TheJonBovi/AutomatedSmartBlinds/ASBWeb/ASBWeb/assets/img/testmonial/1.png

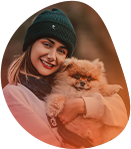
ASBWeb/ASBWeb/assets/img/testmonial/1.png
