TheJonBovi/AutomatedSmartBlinds/ASBWeb/ASBWeb/assets/img/elements/d.jpg

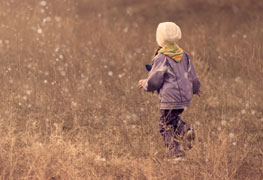
ASBWeb/ASBWeb/assets/img/elements/d.jpg
