TheJonBovi/AutomatedSmartBlinds/Semester1_turn_in/ASB_Presentation_Slides.pdf

# Automated Smart Blinds

### By: Andrew Deraita, Chad Revel, Michael Roberts

# What Are Automated Smart Blinds?

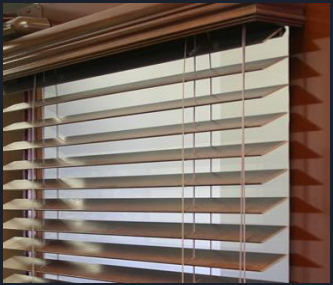
[picture p52: figure]

### - Fully Automated Blinds

### - Controlled By Web Interface

### - Numerous Custom Settings

### - Settings Can Be Changed Web

### Interface

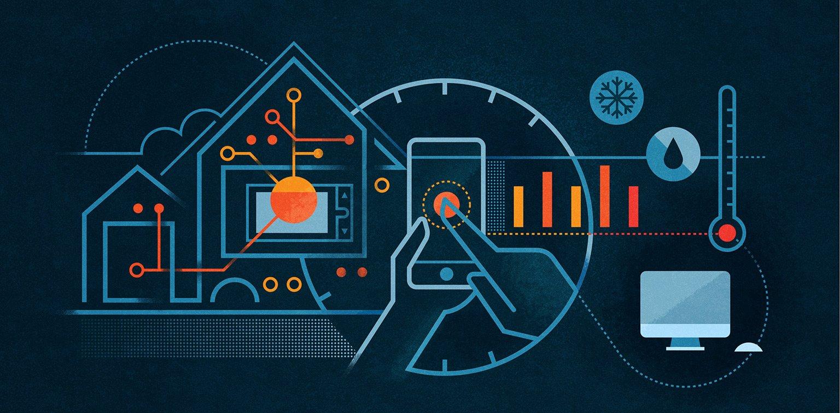
[picture p53: figure]

# Why is this important?

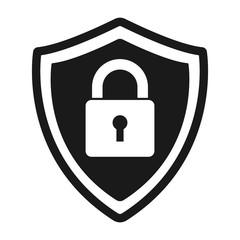
[picture p54: figure]

### - Next Step In Smart Houses

### - Help For Disabled Individuals

### - Security

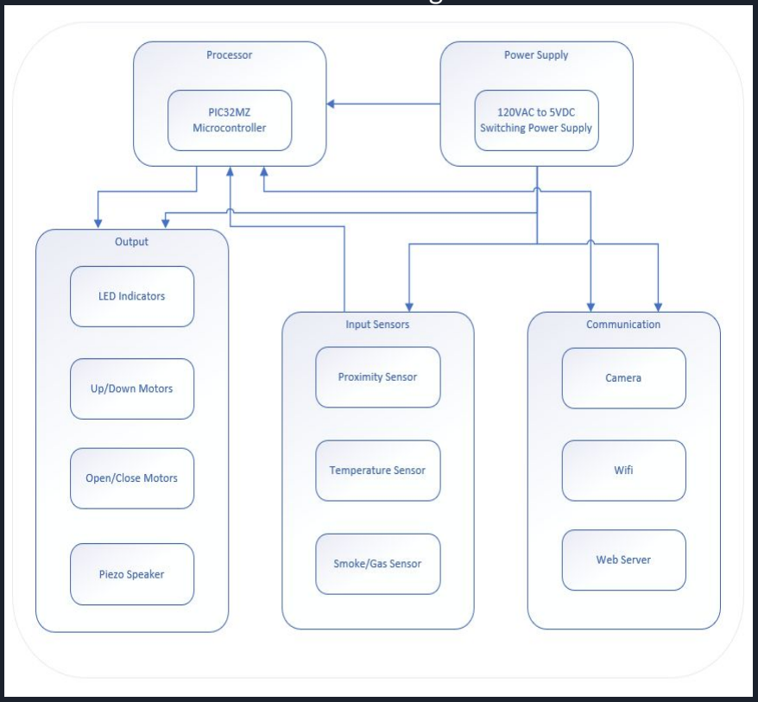
[picture p55: figure]

# How it works

### - Multiple Sensors

- Temperature
- Proximity
- Smoke/Gas

### - Settings like time of day/night

### - User input via web interface

### Overall diagram

# Processor

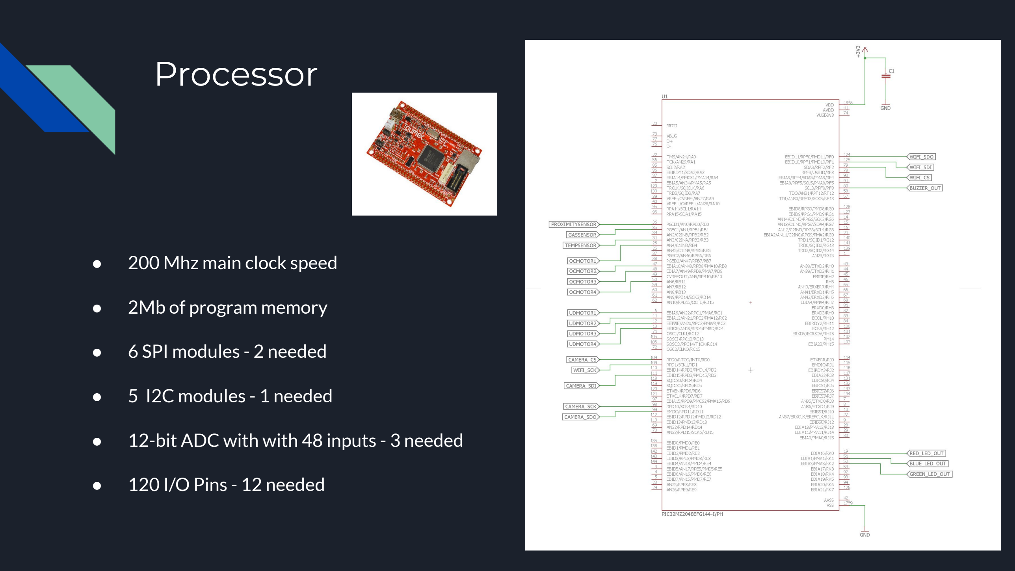
[picture p56: page 5]

### - 200 Mhz main clock speed

### - 2Mb of program memory

### - 6 SPI modules - 2 needed

### - 5 I2C modules - 1 needed

### - 12-bit ADC with with 48 inputs - 3 needed

### - 120 I/O Pins - 12 needed

# Processor RTS Loop

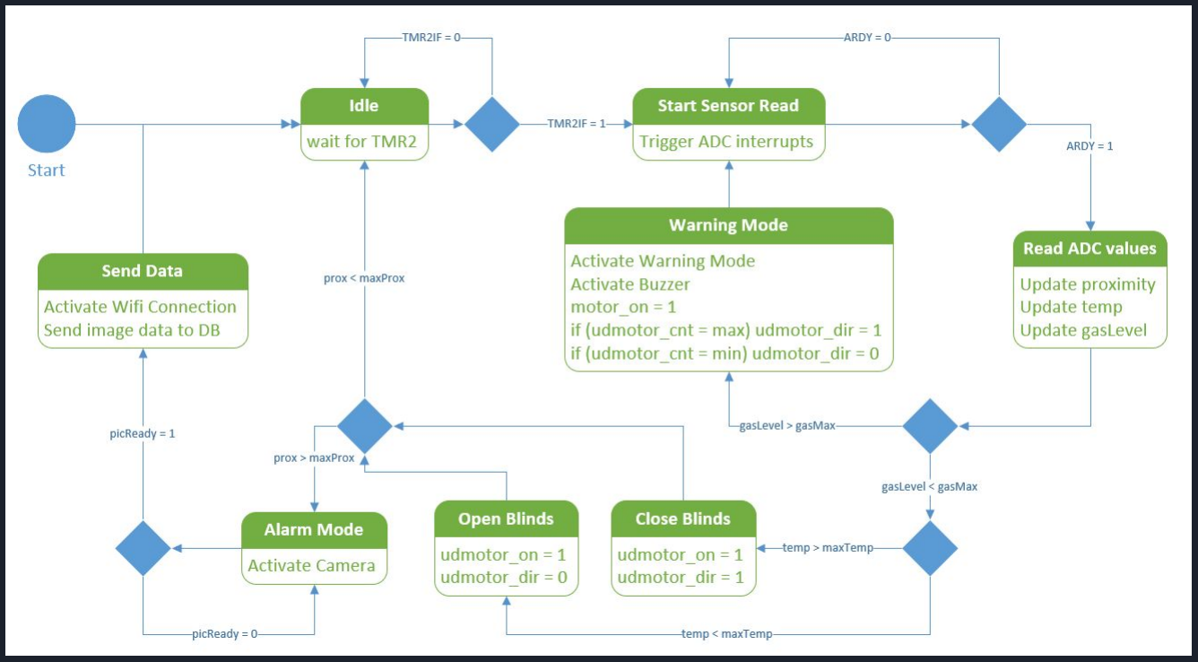
[picture p57: figure]

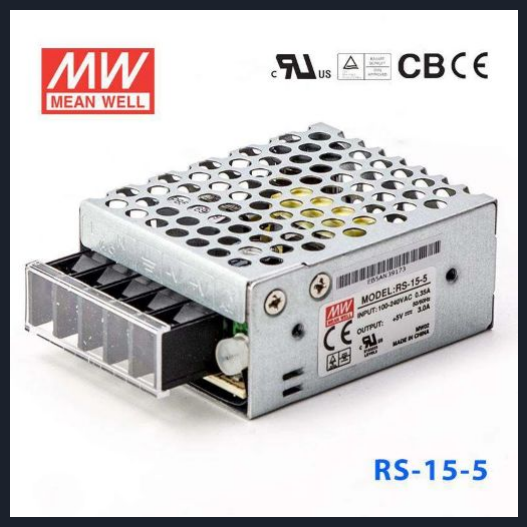
[picture p58: figure]

# Power Supply

### - RS-15-5 5V, 3A Switching Power Supply

### - LM340H 3.3V Linear Power Regulator

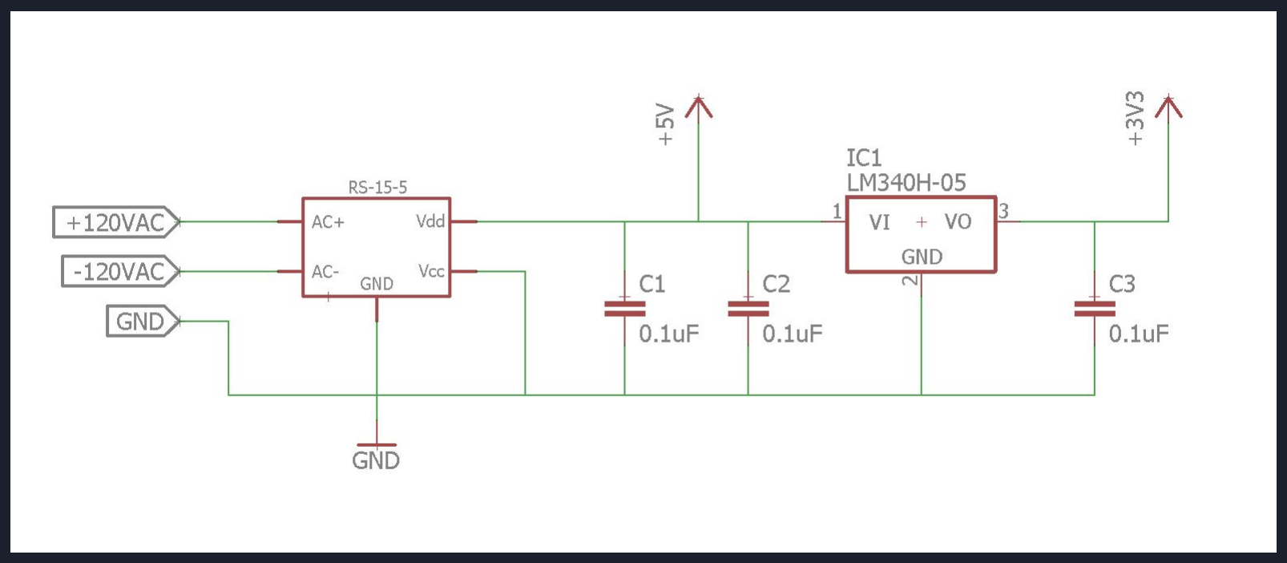
[picture p59: figure]

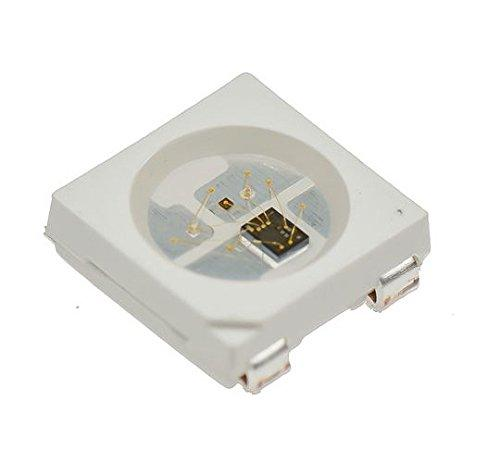
[picture p60: figure]

# LED Indicators

### - High Power 5050RGB LED

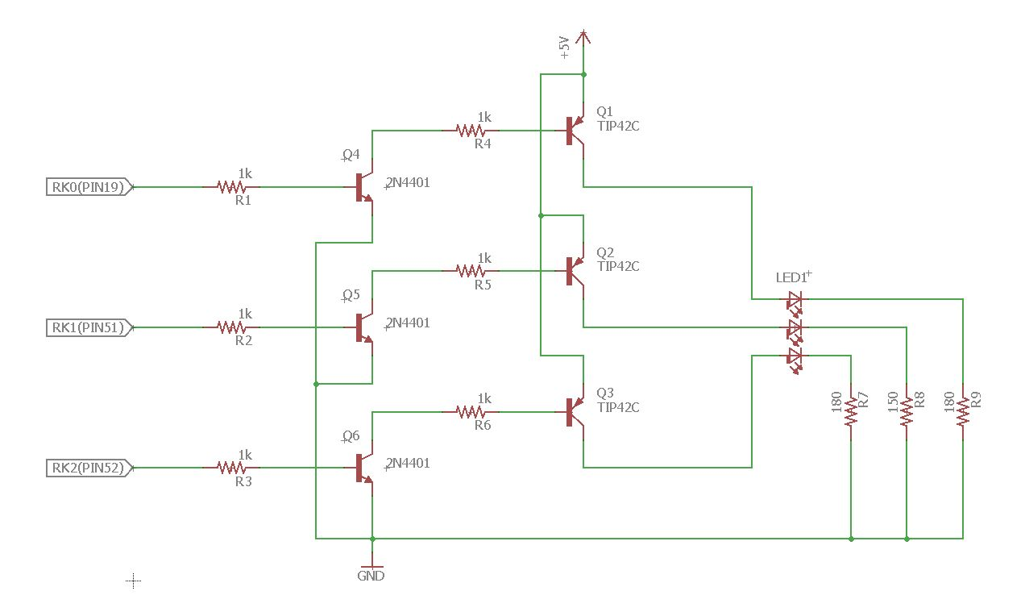
[picture p61: figure]

### - 2-stage power amplification

- Voltage amplification
- Current amplification

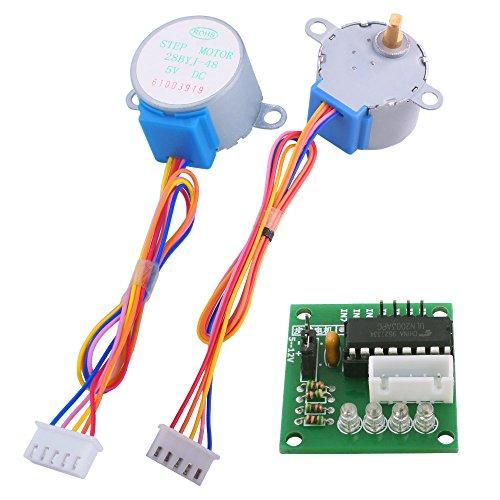
[picture p62: figure]

# Stepper Motor (up/down and open/close)

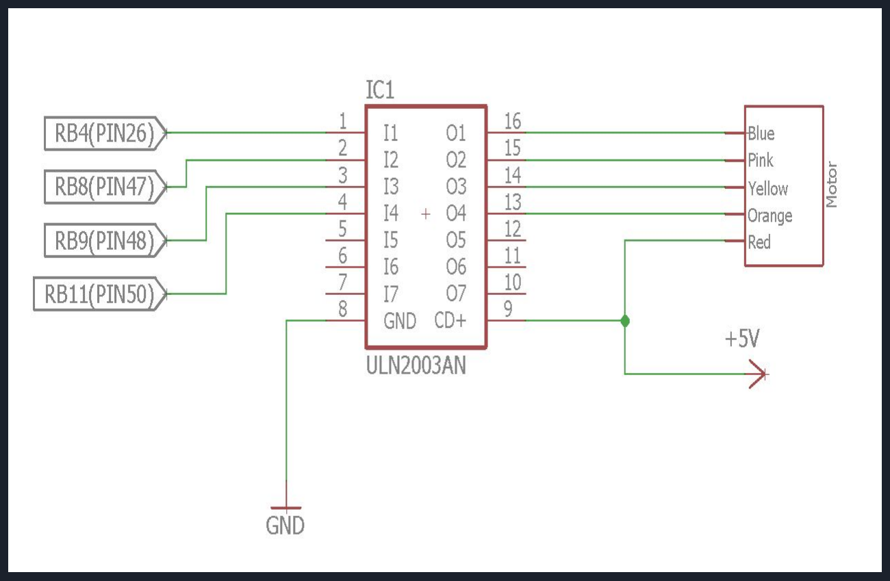
[picture p63: figure]

### - 5V DC

### - 4-Phase

### - 5-Wire

### - ULN2003 Driver Board

### - Pull in Torque 34.4mN.m (120Hz)

### - 8 signals repeated 64 times for one full

### revolution

# Stepper Motor State Machine

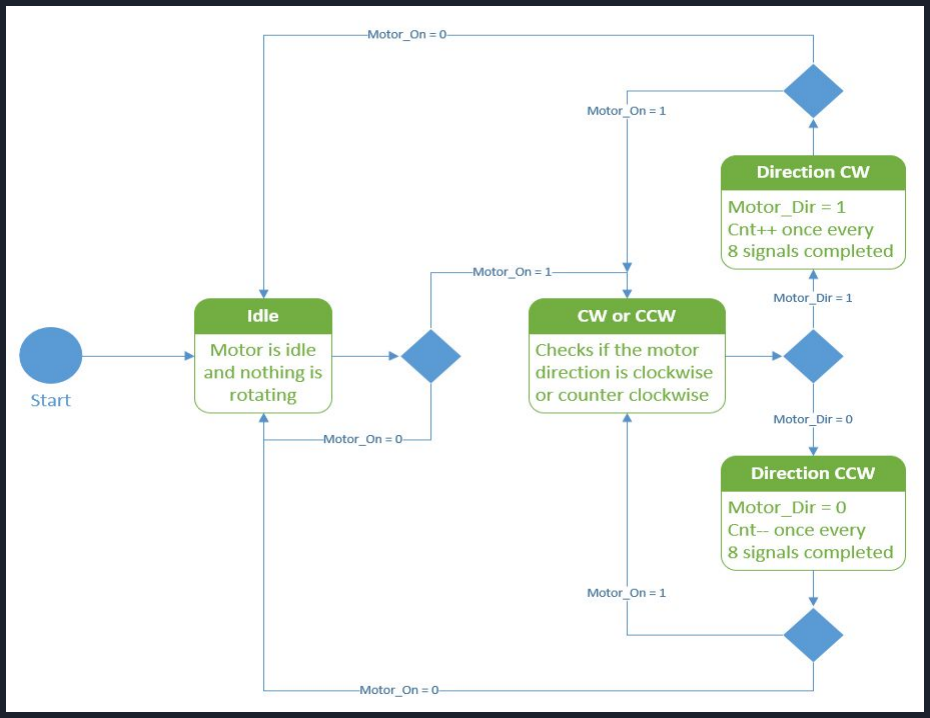
[picture p64: figure]

# Stepper Motor State Machine

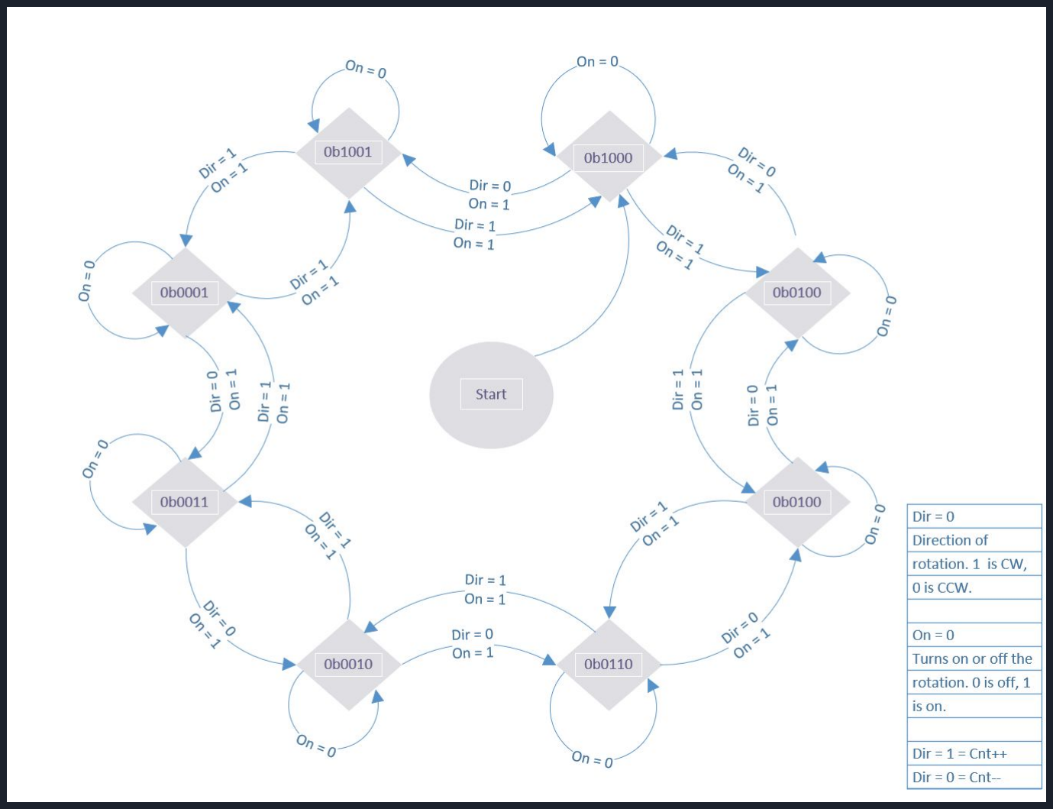
[picture p65: figure]

# Blinds

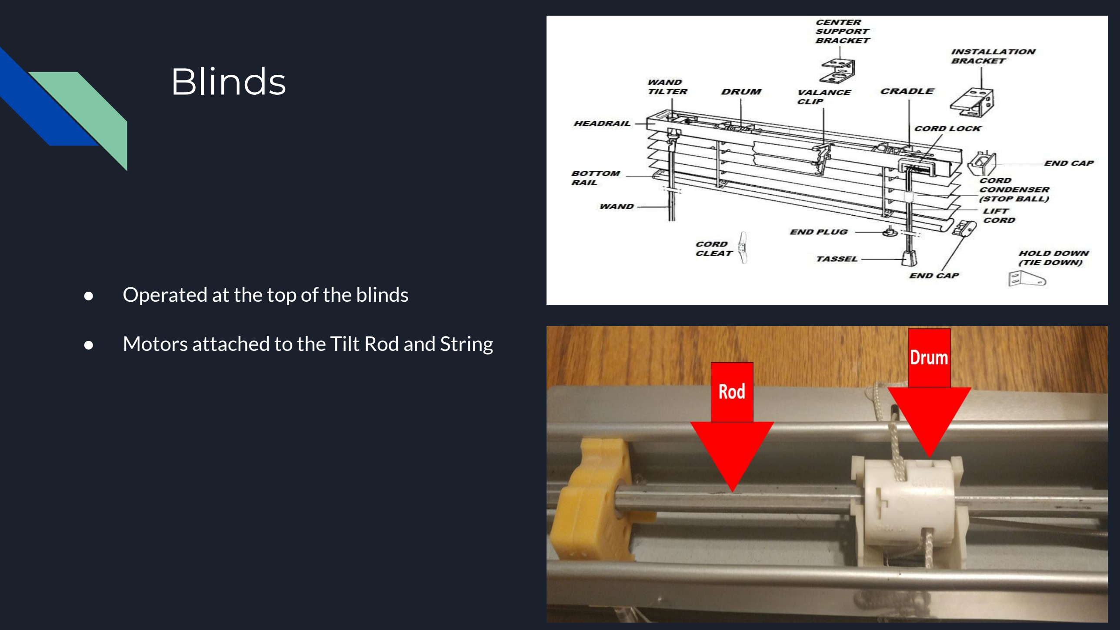
[picture p66: page 12]

### - Operated at the top of the blinds

### - Motors attached to the Tilt Rod and String

# Speaker

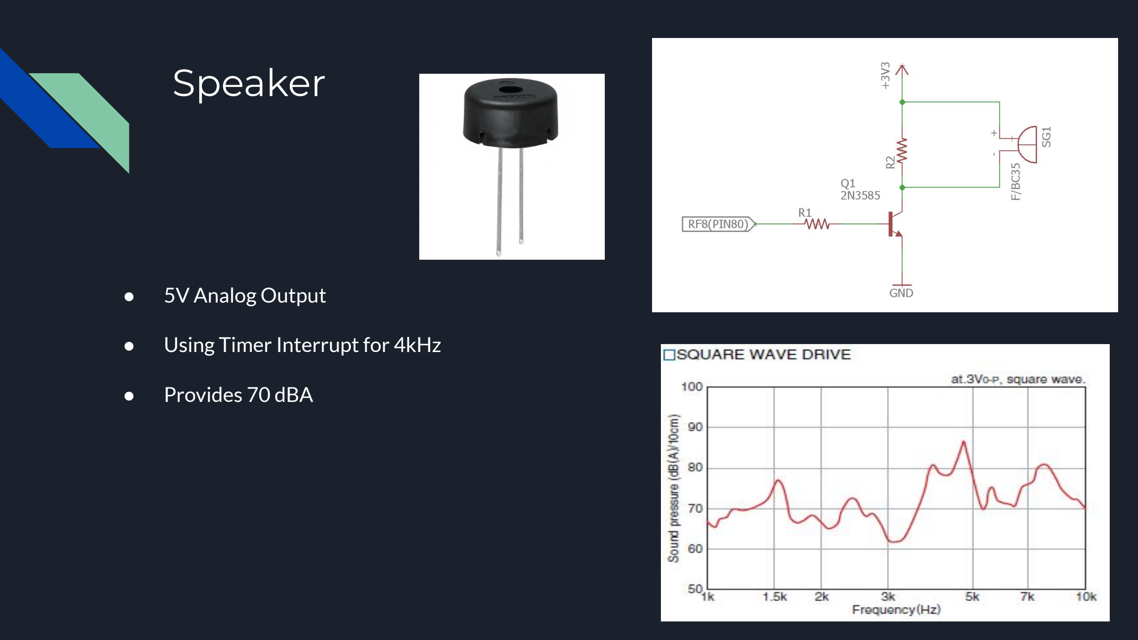
[picture p67: page 13]

### - 5V Analog Output

### - Using Timer Interrupt for 4kHz

### - Provides 70 dBA

# Proximity Sensor

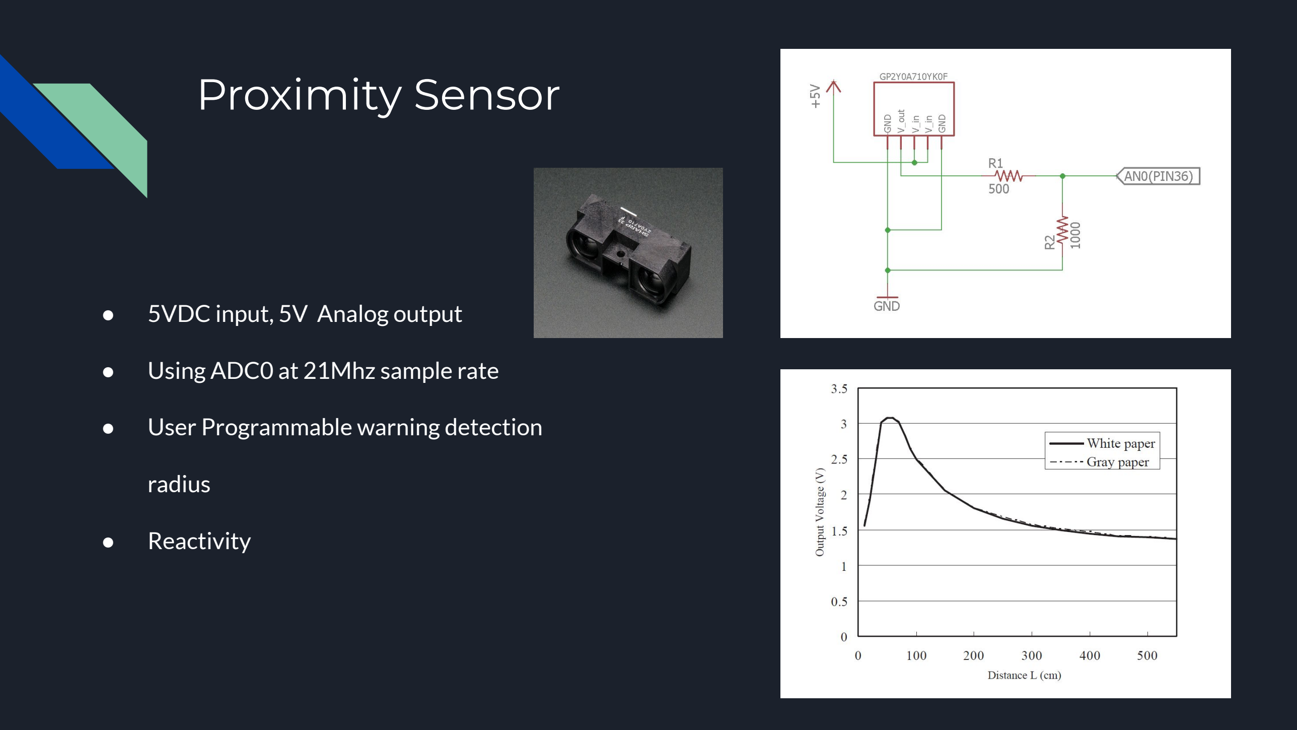
[picture p68: page 14]

### - 5VDC input, 5V Analog output

### - Using ADC0 at 21Mhz sample rate

### - User Programmable warning detection

### radius

### - Reactivity

# Temperature Sensor

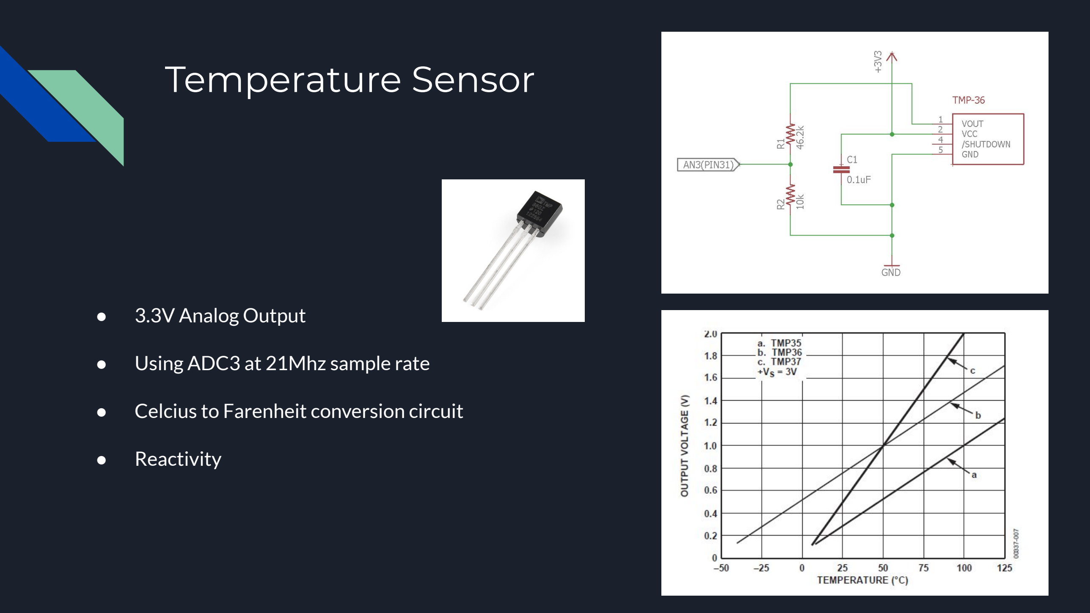
[picture p69: page 15]

### - 3.3V Analog Output

### - Using ADC3 at 21Mhz sample rate

### - Celcius to Farenheit conversion circuit

### - Reactivity

# Smoke/Gas Sensor

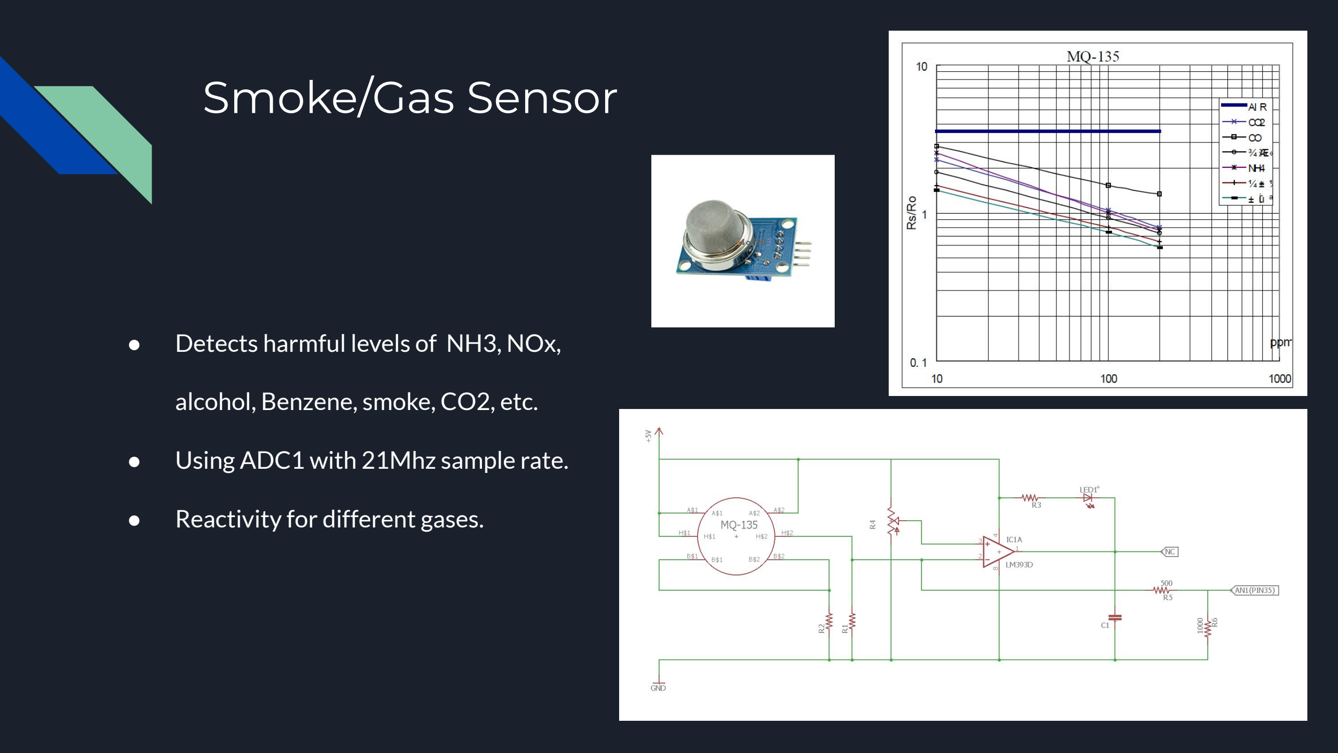
[picture p70: page 16]

- Detects harmful levels of NH3, NOx,

alcohol, Benzene, smoke, CO2, etc.

- Using ADC1 with 21Mhz sample rate.
- Reactivity for different gases.

# Camera

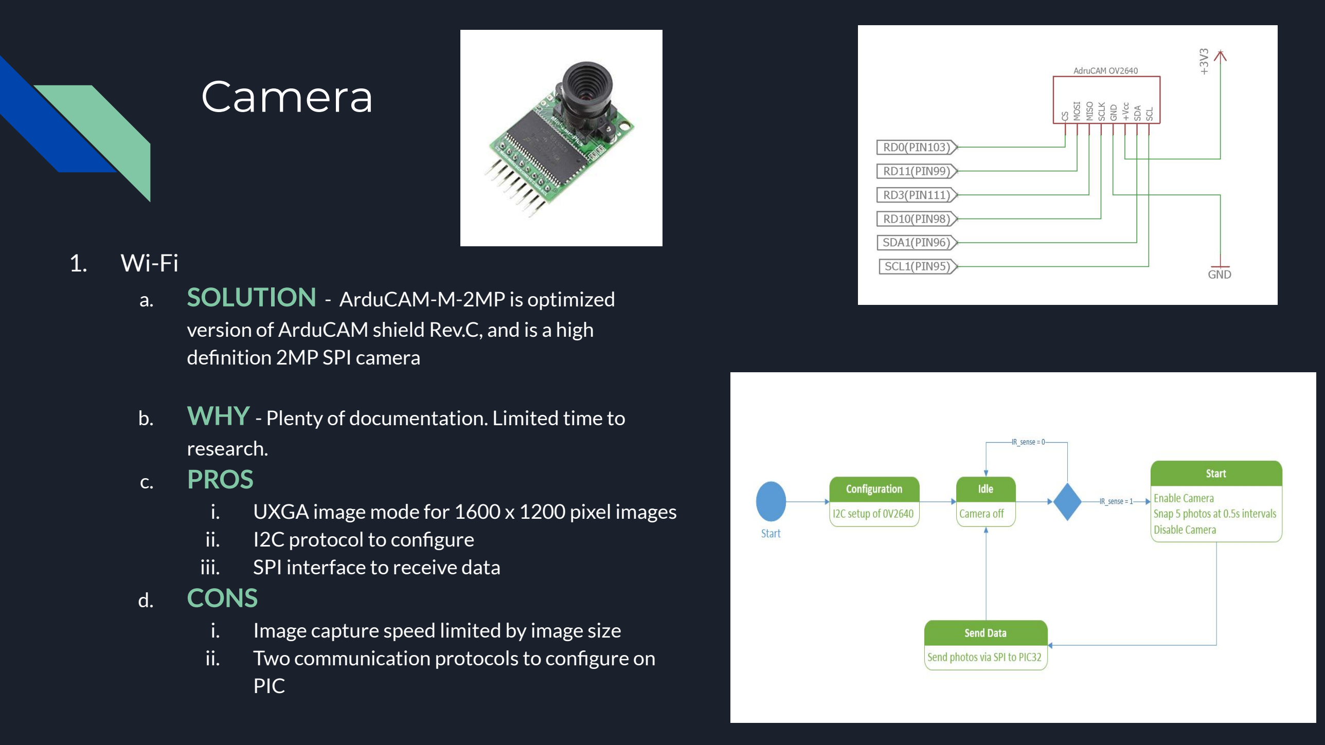
[picture p71: page 17]

### 1. Wi-Fi

a. SOLUTION - ArduCAM-M-2MP is optimized version of ArduCAM shield Rev.C, and is a high definition 2MP SPI camera
b. WHY - Plenty of documentation. Limited time to research.

### c. PROS

i. UXGA image mode for 1600 x 1200 pixel images
ii. | I2C protocol to configure
iii. | SPI interface to receive data

### d. CONS

i. Image capture speed limited by image size
ii. | Two communication protocols to configure on
| PIC

# Communications (Hardware)

### 1. Wi-Fi

a. SOLUTION - IEEE 802.11, (b/g/n) standard specifications. TCP/IP Stack
b. WHY - Current Trend in IoT is to used WiFi. Stretch goal to incorporate video streaming. Also, couldn’t find a bluetooth module to support video application in enough time before initial parts had to be ordered. We knew all End-User devices could connect to a local network.

### c. PROS

i. Scalability
ii. Connectivity - can be connected to remotely via internet

### d. CONS

i. Cost vs RFID, Bluetooth
ii. Power vs RFID, Bluetooth
e. TEST - Arduino, SAMD21

# Communications (Software)

### 1. User Interface

a. SOLUTION - WISA(Microsoft Windows, Microsoft IIS, Microsoft SQL, ASP.NET(4.6.1) Stack
b. WHY - A lot of options and documentation

### c. PROS

i. Team members are all Windows users and familiar with visual studios, C, C++,C#

### d. CONS

i. Expensive
ii. Heavy

### e. TEST

i. Unit tests/Data logging

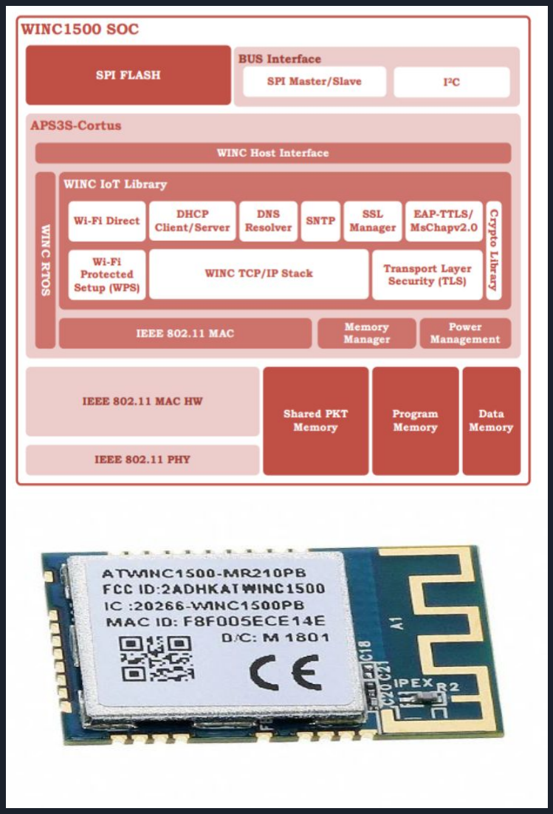
[picture p72: figure]

# Wifi - Module

### 1. Wi-Fi

a. ATWINC1500 - MR210PB (uses AP838 Cortus 32

bit 40 MHz CPU executes the Winc firmware.)

b. Very heavily documented
c. WINC1500 WINC host driver software is a C

library which provides the host MCU application

with necessary APIs to perform necessary WLAN

and socket operations.

# Wifi - Module

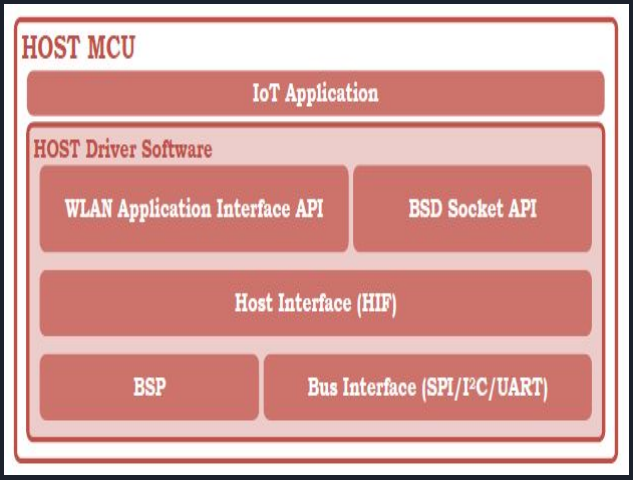
[picture p73: figure]

### WLAN API

This module provides an interface to the application for all Wi-Fi operations and any non-IP related operations.

### Socket API

This module provides the socket communication APIs that are mostly compliant with the well-known BSD sockets to enable rapid application development.

### Host Interface (HIF)

The Host Interface is responsible for handling the communication between the host driver and the WINC Firmware.

### Board Support Package (BSP)

The Board Support Package abstracts the functionality of a specific host MCU platform.

# User Interface Module

### Tier 1 - User Interface

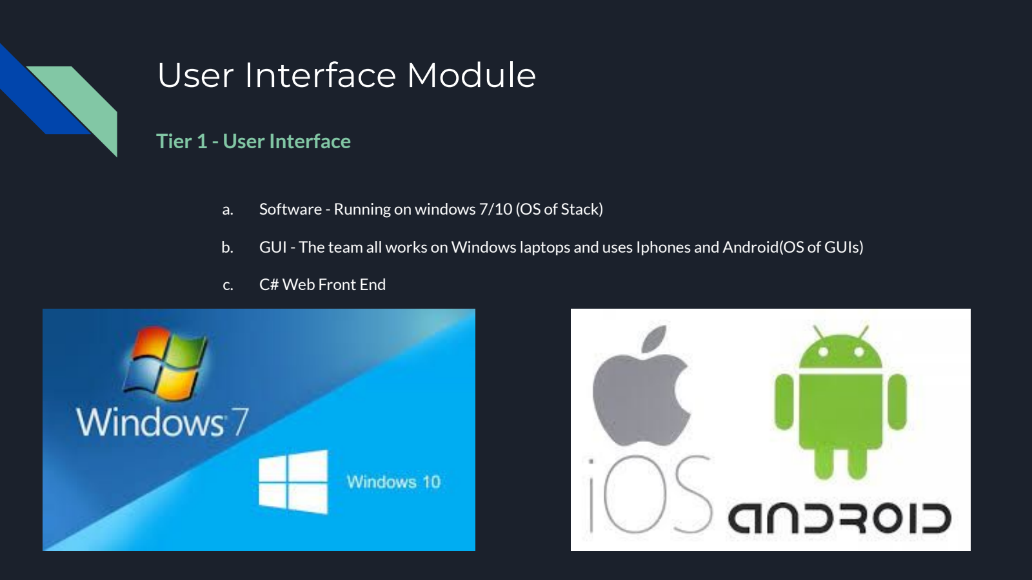
[picture p74: page 22]

a. Software - Running on windows 7/10 (OS of Stack)
b. GUI - The team all works on Windows laptops and uses Iphones and Android(OS of GUIs)
c. C# Web Front End

# User Interface Module

### Tier 2 - Business layer

a. Microsoft Internet Information Services
b. Visual Studios, C#
c. Web Services
d. Real-Time (Signalr)

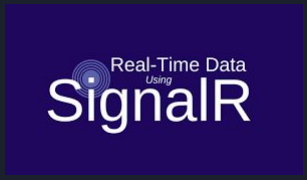
[picture p75: figure]
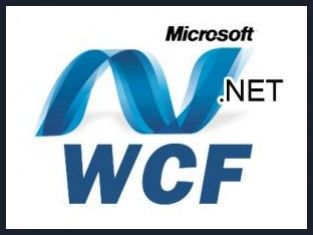
[picture p76: figure]
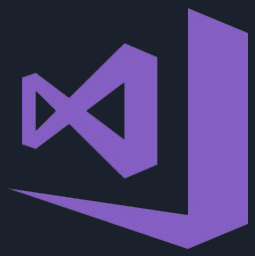
[picture p77: figure]
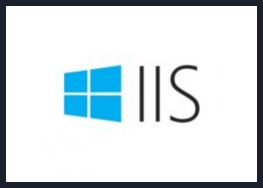
[picture p78: figure]

# User Interface Module

### Tier 3 - Database

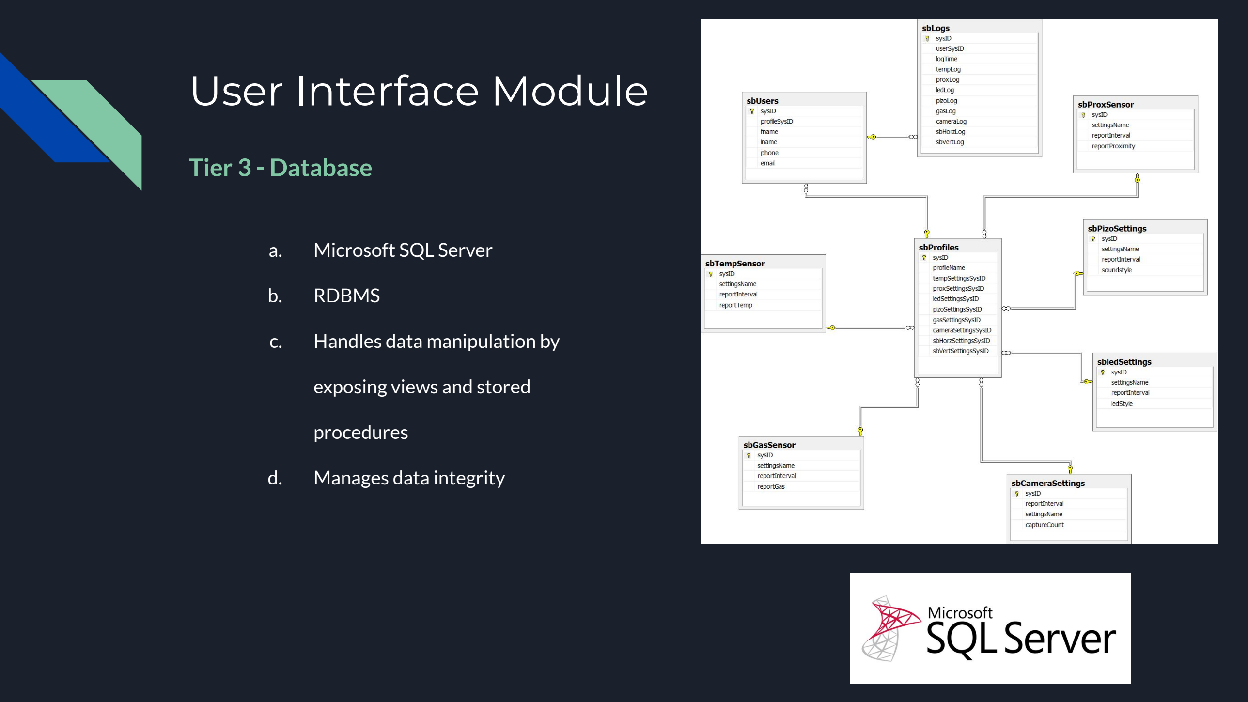
[picture p79: page 24]

a. Microsoft SQL Server
b. RDBMS
c. Handles data manipulation by

exposing views and stored

procedures

d. Manages data integrity

# User Interface Demonstration

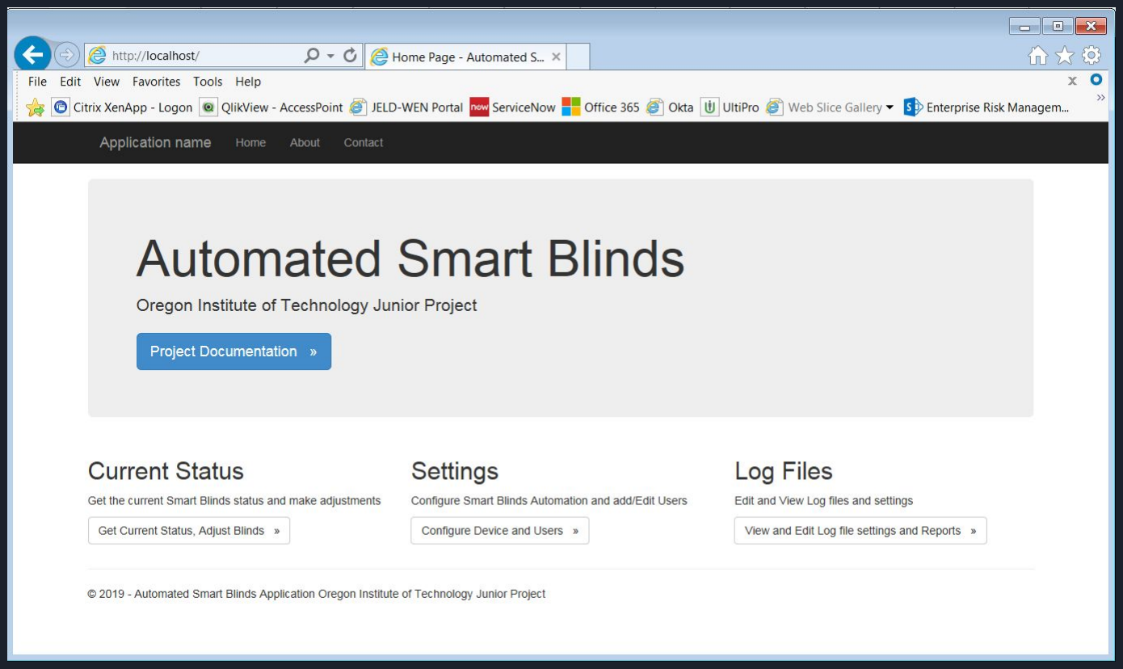
[picture p80: figure]

# Cost

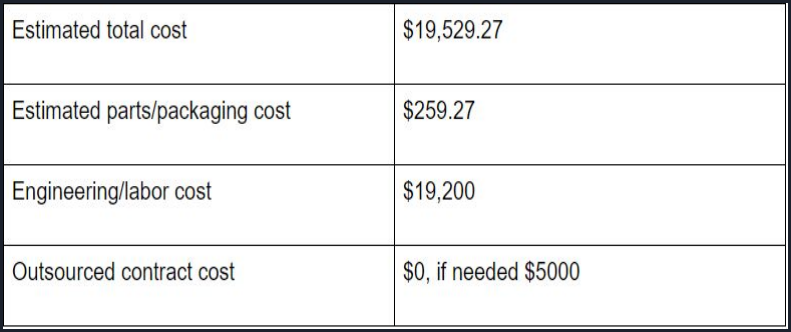
[picture p81: figure]

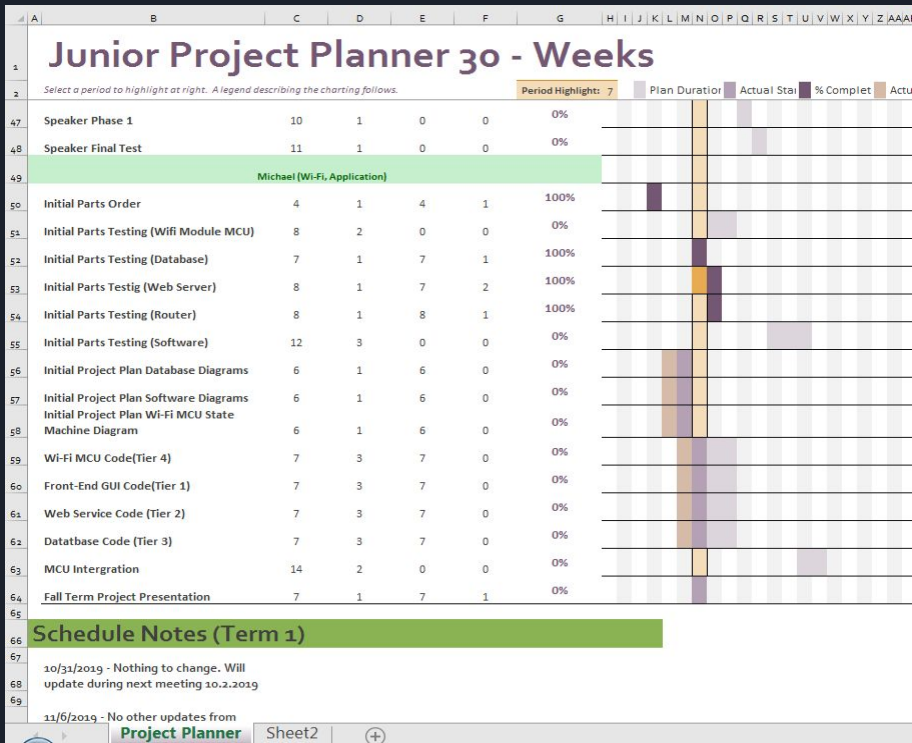
[picture p82: figure]

# Schedule

### - Gantt Chart

### - Updated during team

### meeting starting 2nd Term

### - Annotations and brief status

### updates are included in chart

### - Schedule scratchbook

# Problems and Control

Control for managing the group is done via a “Three Strike” policy. If a member fails to meet their

deadlines for project sections or communication receive a strike. Accumulation of three strikes

can result in being removed from the group.

Issues with submodules code or hardware are given a one week all-hands review before seeking

outside help.

# Conclusion

- Full Automated Smart Blinds is the next part for Smart houses.

### - Potential Market Growth

- Helping Advance Technology for everyday individuals.

# References

### - Data Sheets Used

- PIC32-HMZ144 User’s Manual
- PIC32 Datasheet
- RS-15 SPEC Power Supply
- 5V 4 Phase 5 Wire Stepper Motor & ULN2003 Driver Board
- Piezoelectric buzzers PS series
- Sharp GP2Y0A710K0F Proximity Sensor
- Low Voltage Temperature Sensor Data Sheet TMP35/36/37
- MQ-135 Gas Sensor Technical Data Sheet
- ArduCam-M-2MP Camera Shield User Guide
- ATWINC15X0 Wifi Controller Software Guide

### - Images Used

- https://www.crowdcontent.com/blog/2013/08/13/6-ways-to-get-more-from-your-how-to-content/ (https://www.crowdcontent.com/blog/2013/08/13/6-ways-to-get-more-from-your-how-to-content/)
- https://cdn.theatlantic.com/assets/media/img/sponsored/2015/04/theatlantic_emerson_D2energy/resp-feature.jpg (https://cdn.theatlantic.com/assets/media/img/sponsored/2015/04/theatlantic_emerson_D2energy/resp-feature.jpg)
- https://previews.123rf.com/images/martialred/martialred1507/martialred150700910/42621129-s ecurity-shield-lock-line-art-icon-for-apps-and-we bsites.jpg (https://previews.123rf.com/images/martialred/martialred1507/martialred150700910/42621129-security-shield-lock-line-art-icon-for-apps-and-websites.jpg)
- https://mountainwestcomputers.com/is-it-time-to-replace-my-windows-7-computer-maybe/ (https://mountainwestcomputers.com/is-it-time-to-replace-my-windows-7-computer-maybe/)
- https://keyholesoftware.com/2015/02/02/real-time-data-using-signalr/ (https://keyholesoftware.com/2015/02/02/real-time-data-using-signalr/)
- https://www.itprotoday.com/business-resources/sql-server-2017-release-candidate-1-available-d ownload (https://www.itprotoday.com/business-resources/sql-server-2017-release-candidate-1-available-download)
- https://www.iis.net/
