TheJonBovi/AutomatedSmartBlinds/documentation/PIC32MZ to WINC1500(WINC1500 to PIC).pdf

Andy Appeldorn
2017-03-02

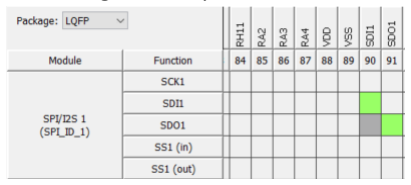
[picture p83: figure]
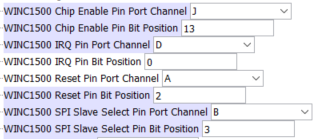
[picture p84: figure]

PIC32MZ EF STK to WINC1500 | Page 1

# PIC32MZ EF STK to WINC1500

The purpose of this document is to provide brief instruction on how to connect a WINC1500 Xplained Pro development board to a PIC32MZ EF STK to demonstrate WINC1500 support within Harmony.

Important: Before starting, connect WINC1500 Xplained Pro dev board to a supported SAMD21 Xplained Pro board (or any supported dev board). Using Atmel Studio, open or create an ASF WINC1500 Firmware Updater project and follow instructions in the user guide located in the /docs folder. WINC1500 module must be running FW v19.5.2 or greater for SoftAP function. DFU from within Harmony application will be supported in the future. Contact WSG apps to obtain WINC1500 update image.

Wire wrap connections to connect PIC32MZ EF STK to WINC1500 Xplained Pro dev board as indicated in wiring chart in the wiring section of this document. Recommend using a male-male header on the WINC1500, if possible, to make it easy to remove WINC1500 for other use.

Open Harmony “wifi_easy_conguration” project from Harmony v2.02b or later. Select project configuration ”pic32mz_ef_sk__ioexp__winc__freertos”. Start MHC and make the following changes.

- In MHC Pin Manager, modify SPI MOSI and MISO port pins to reflect connections in wiring chart.

o
- In MHC Options tab navigate to “Harmony Framework Configuration/Drivers/Wi-Fi” and modify according to the wiring chart.

o
- In MHC Options tab, navigate to “Harmony Framework Configuration /System Services/Interrupts” and change external source to INT_EXTERNAL_INT SOURCE0.

o
- WAKE pin is not controlled by the WINC1500 driver. In MHC Pin Settings, set this pin to a High Output.

o

- In MHC Options tab “Harmony Framework Configuration/Drivers/SPI/SPI Driver Instance 0”, slow down SPI port since we are using wire wrap and not PCB trace connections. The speed will depend on the length and gauge of your wiring. I was able to run a 4MHz clock w/o issues.

o

- Save MHC settings and Generate code.
- No manual source code modification is necessary.
- Build and program device in release or debug mode.
- Connect computer to PIC32MZ EF STK via USB device connection to verify operation. Open serial terminal session; hit any key to view console messages. Successful initialization should output the following:

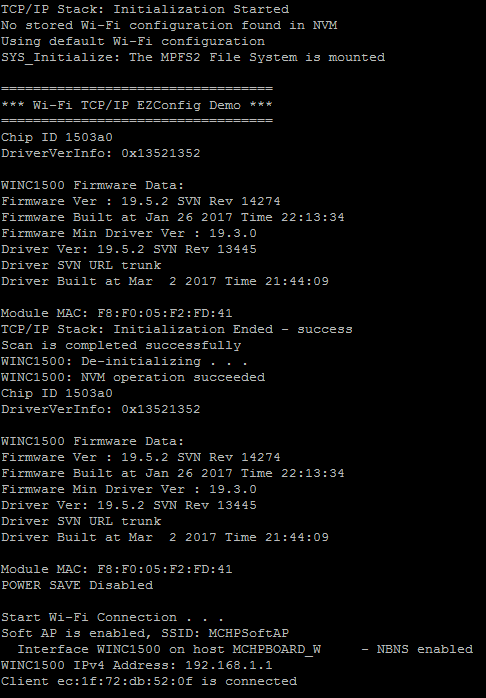
[picture p85: figure]

o

* Note: When operating HTTP server demo web page, response may be slow due to decreased SPI data rates.

Wiring Chart for PIC32MZ EF STK to WINC1500 Xplained Pro Demo.

Function | WINC1500 Xpl Pro Header Pin | PIC32MZ EF STK 40 Pin Header (wire wrapped settings) | PIC32MZ EF STK default (for reference)
RESET_N | 5 | 5 (RA2) | RF0
WAKE | 6 | 7 (RA14) | NC
IRQ_N | 9 | 11 (RD0, INT0) | RE8
CHIP_EN | 10 | 13 (RJ13) | RE0
SPI_SSN | 15 (SPI_SS) | 15 (RB3) | RE9
SPI_MOSI | 16 (SPI_MOSI) | 19 (RF5, SDO1) | RD10 (SDO1)
SPI_MISO | 17 (SPI_MISO) | 21 (RF4, SDI1) | RD14 (SDI1)
SPI_SCK | 18 (SPI_SK) | 23 (RD1, SCK1) | RD1 (SCK1)
Vcc | 20 | 17
GND | 19 | 9

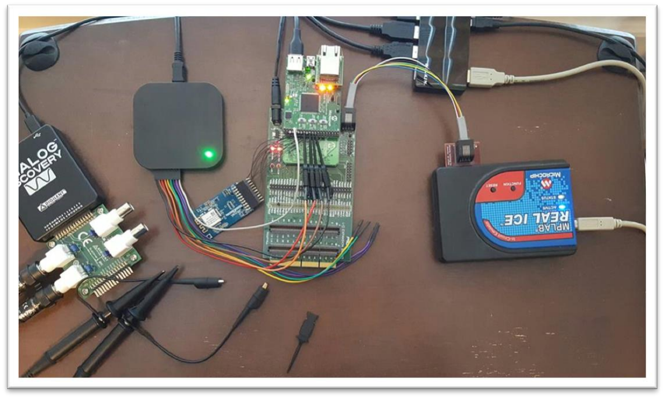
[picture p86: figure]

*note: it is not necessary to use the I/O expansion board and adapter.

### PIC32MZ EF Starter Kit Information:

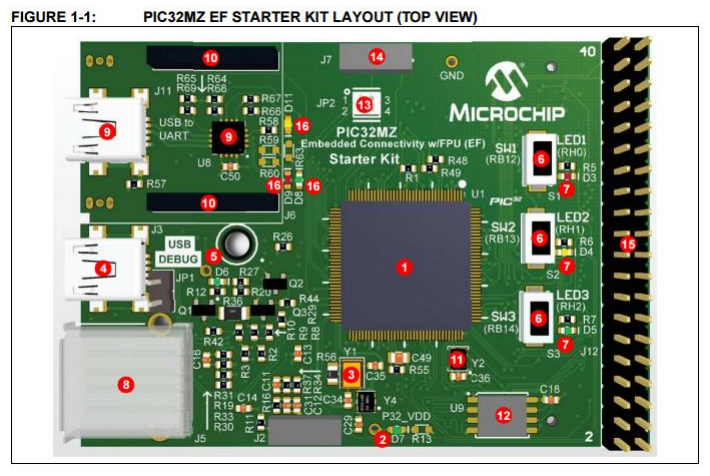
[picture p87: figure]
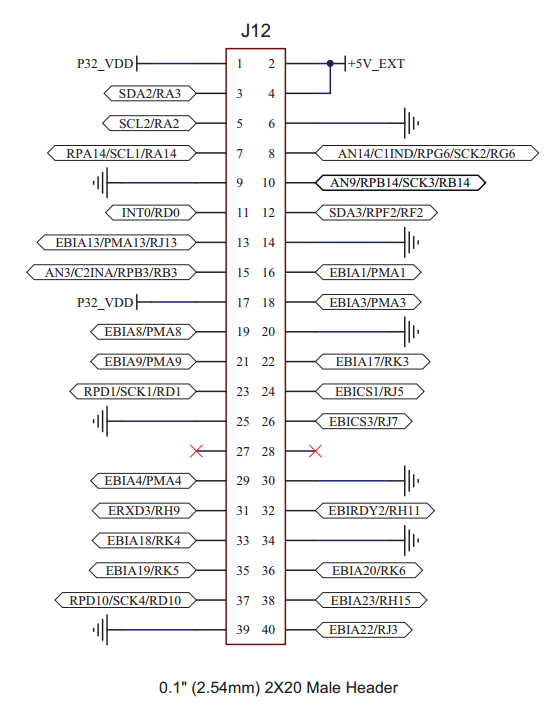
[picture p88: figure]

### WINC1500 Xplained Pro Eval Board Info:

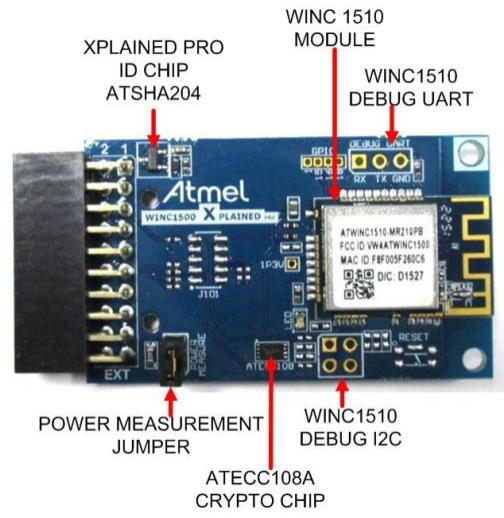
[picture p89: figure]
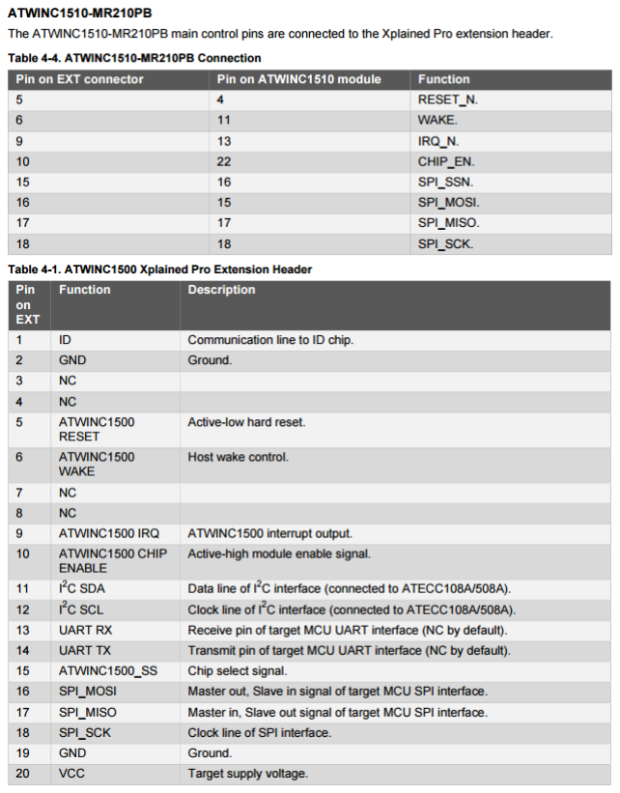
[picture p90: figure]

### Xplained Pro Header Pinout:

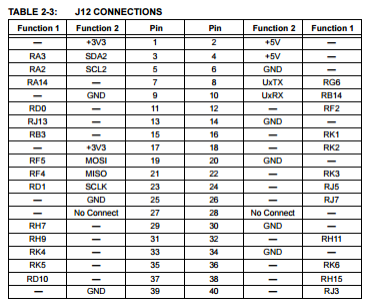
[picture p91: figure]
