TheJonBovi/AutomatedSmartBlinds/ASBproject/AutomatedSmartBlinds/WebAppServices1/pictures/rubric_proposal.xls

Rubric for project proposal
 | Highest level of competence | Instructor comments | Student comments
Timely submission | 5 pts: by 5:00 pm of 3rd week. 2 pts off up to total of 5 pts for each day late.
Format/Organization | 5 pts: typed, double space, cover page, table of content, list of figures, list of tables, abstract, main body, conclusion
Spelling errors | 5 pts: each spelling error incurs 1 pt off up to total of 5 pts
Grammatical errors | 5 pts: each grammatical error incurs 1 pt up to a total of 5 pts
Identification of existing problem requiring solutions | 10 pts: get with Prof.N to agree on major problem which the project is to solve. Identify ALL details/sub-problems to satisfy all of Prof. N's whim.
Identification of possible customers/markets | 5 pts: get with Prof.N to agree on ALL possible customers and markets for the project. Identify possible customers which team will contact. Make contact!
Abstract | 5 pts: one to two pages abstract outlining the entire project
Team make-up | 5 pts: identify team members and qualifications
Identify how project would "technically" solve each of previously identified problems/sub-problems | 20 pts: identify ALL details of the "technical" problem to be formulated and solved. Break large technical problems down to smaller sub-problems. Identify sub-problems which will be solved by project. Explain why some sub-problems will not be solved. Use a hierachichal block diagram at this time to show clearly how the team will initially tackle the solutions.Note: make sure to include power supply as one of your sub-problem
Specifications of each solution- how to solve, how much to solve, sizes of solutions… | 20 pts:for each technical sub-problem, describe in as much detail as possible the specifications of each soultion. For example, if the power supply is to be a battery, the specification should include power requirements, how long battery last, dimensions of battery, dimensions of packaging for battery...
Preliminary parts list/commitment to certain percentage of variation preliminary list | 5 pts: estimated list of all parts broken down into precised, categorized modules. Identify alternative parts, redundant parts. Estimate and justify how much the project team will allow itself to deviate from this initial parts list.
Software requirements | 5 pts: identify required software tools for entire project
Preliminary cost | 5 pts: estimated total cost. Estimated parts/packaging cost, engineering cost, labor cost, outsourced contract cost... Tabular format. Clear explanation of basis for estimation. Estimate and justify how much the project team will allow itself to deviate from this initial cost estimation.
