TheJonBovi/AutomatedSmartBlinds/ASBproject/AutomatedSmartBlinds/WebAppServices1/pictures/1024x768.jpg

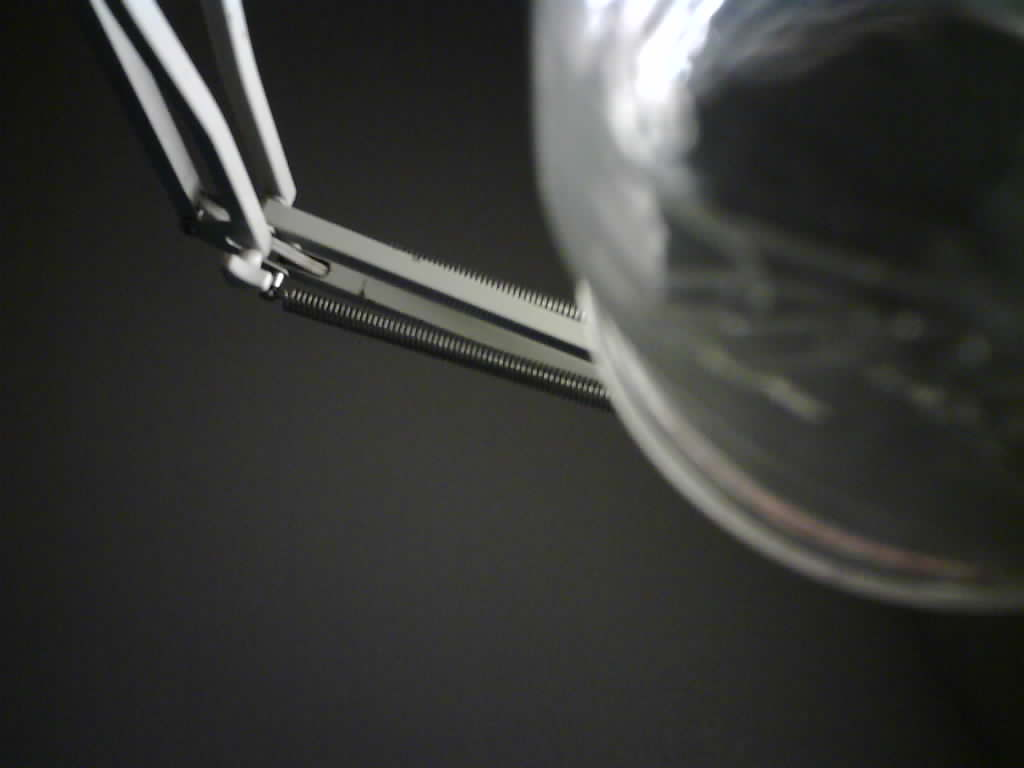
ASBproject/AutomatedSmartBlinds/WebAppServices1/pictures/1024x768.jpg
