TheJonBovi/AutomatedSmartBlinds/ASBWeb/ASBWeb/assets/img/about/about_lft.png

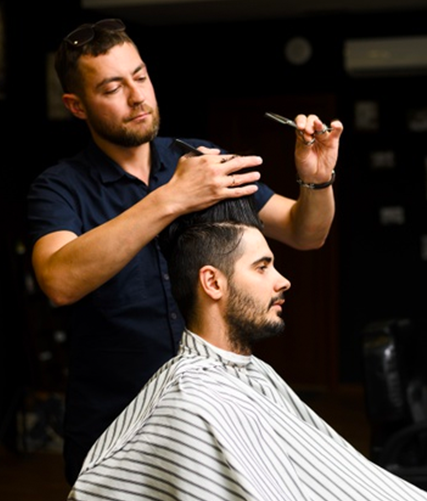
ASBWeb/ASBWeb/assets/img/about/about_lft.png
