TheJonBovi/AutomatedSmartBlinds/ASBWeb/ASBWeb/assets/img/about/about_right.png

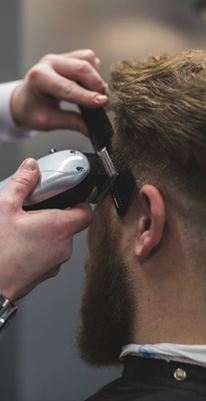
ASBWeb/ASBWeb/assets/img/about/about_right.png
