TheJonBovi/AutomatedSmartBlinds/ASBWeb/ASBWeb/assets/img/about/pet_care.png

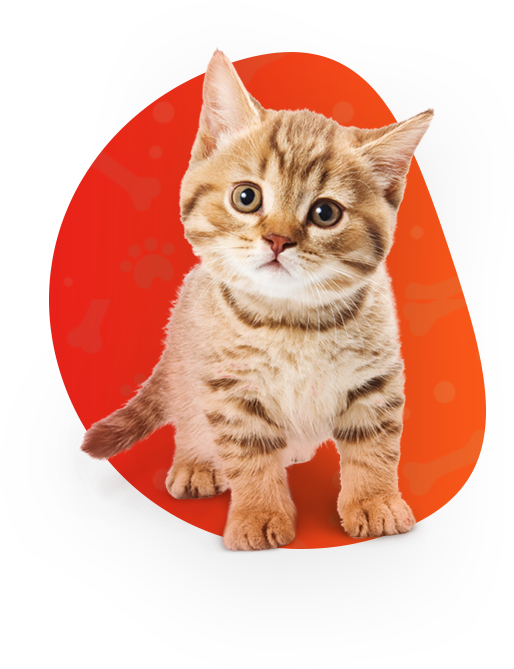
ASBWeb/ASBWeb/assets/img/about/pet_care.png
