TheJonBovi/AutomatedSmartBlinds/ASBWeb/ASBWeb/assets/img/blog/blog_1.png

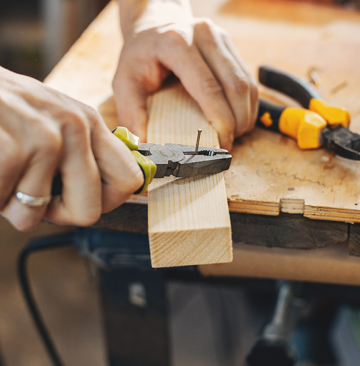
ASBWeb/ASBWeb/assets/img/blog/blog_1.png
