TheJonBovi/AutomatedSmartBlinds/ASBWeb/ASBWeb/assets/img/blog/blog_2.png

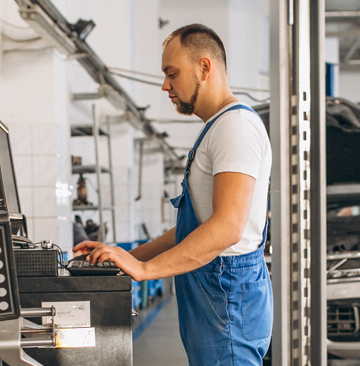
ASBWeb/ASBWeb/assets/img/blog/blog_2.png
