TheJonBovi/AutomatedSmartBlinds/ASBWeb/ASBWeb/assets/img/blog/blog_3.png

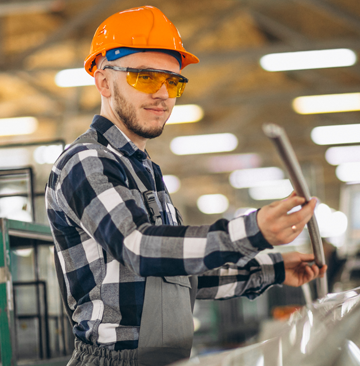
ASBWeb/ASBWeb/assets/img/blog/blog_3.png
