TheJonBovi/AutomatedSmartBlinds/ASBWeb/ASBWeb/assets/img/blog/blog_4.png

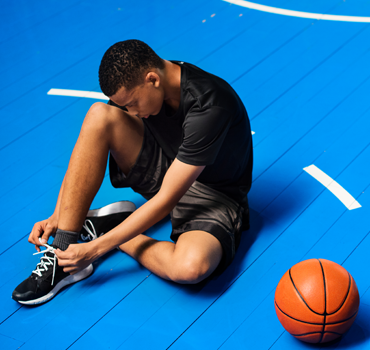
ASBWeb/ASBWeb/assets/img/blog/blog_4.png
