TheJonBovi/AutomatedSmartBlinds/ASBWeb/ASBWeb/assets/img/blog/learn_about_bg.png

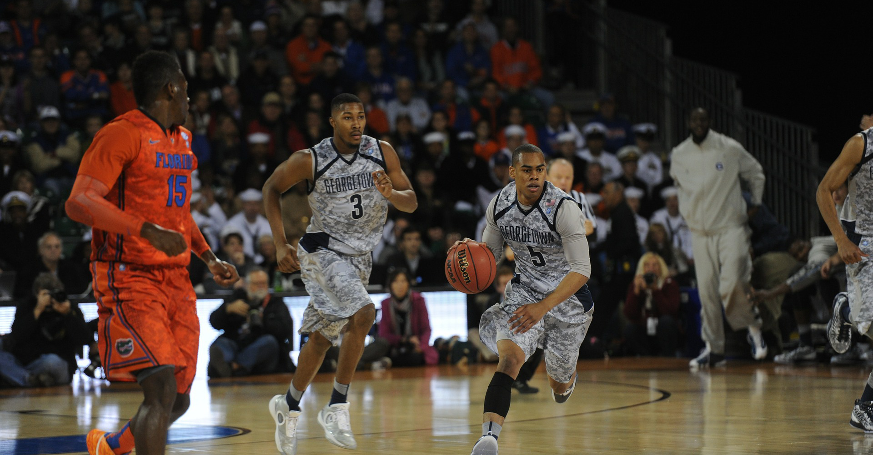
ASBWeb/ASBWeb/assets/img/blog/learn_about_bg.png
