TheJonBovi/AutomatedSmartBlinds/ASBWeb/ASBWeb/assets/img/blog/single_blog_1.png

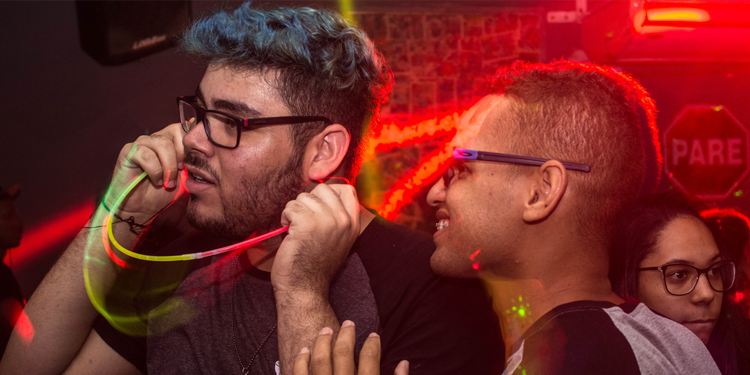
ASBWeb/ASBWeb/assets/img/blog/single_blog_1.png
