TheJonBovi/AutomatedSmartBlinds/ASBWeb/ASBWeb/assets/img/blog/single_blog_2.png

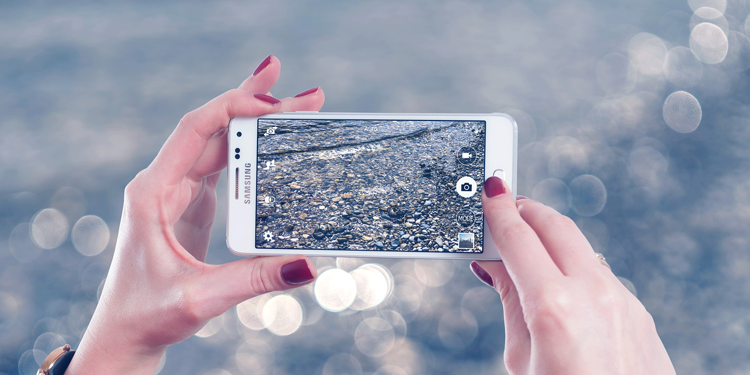
ASBWeb/ASBWeb/assets/img/blog/single_blog_2.png
