TheJonBovi/AutomatedSmartBlinds/ASBWeb/ASBWeb/assets/img/blog/single_blog_3.png

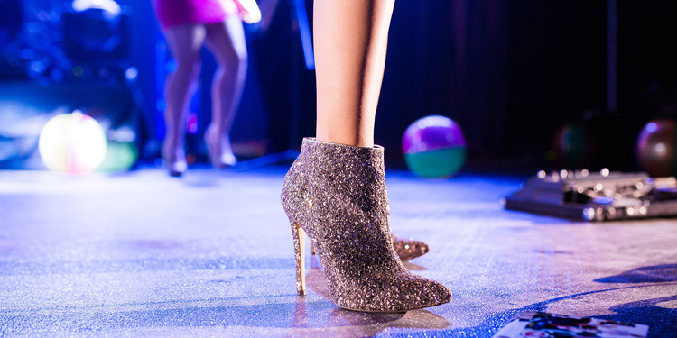
ASBWeb/ASBWeb/assets/img/blog/single_blog_3.png
