TheJonBovi/AutomatedSmartBlinds/ASBWeb/ASBWeb/assets/img/blog/single_blog_4.png

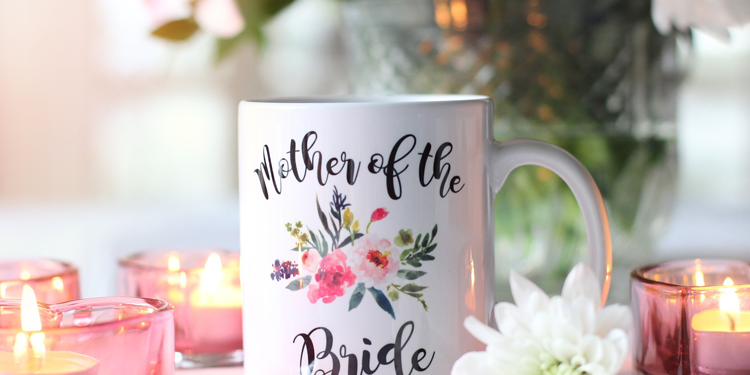
ASBWeb/ASBWeb/assets/img/blog/single_blog_4.png
