TheJonBovi/AutomatedSmartBlinds/ASBWeb/ASBWeb/assets/img/blog/single_blog_5.png

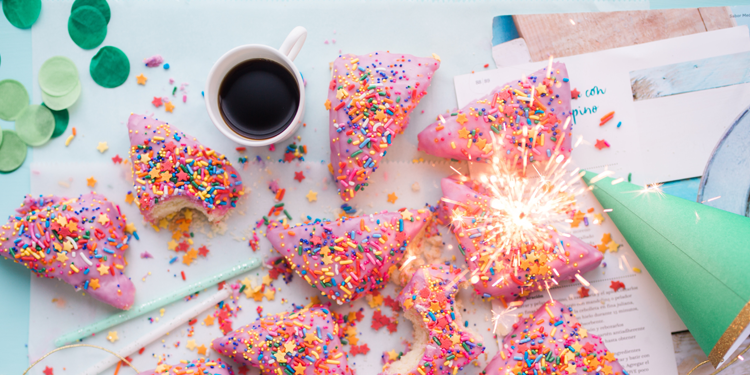
ASBWeb/ASBWeb/assets/img/blog/single_blog_5.png
