TheJonBovi/AutomatedSmartBlinds/ASBWeb/ASBWeb/assets/img/blog/slide_thumb_1.png

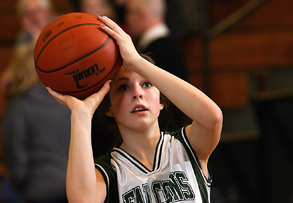
ASBWeb/ASBWeb/assets/img/blog/slide_thumb_1.png
