TheJonBovi/AutomatedSmartBlinds/ASBWeb/ASBWeb/assets/img/david/david_1.png

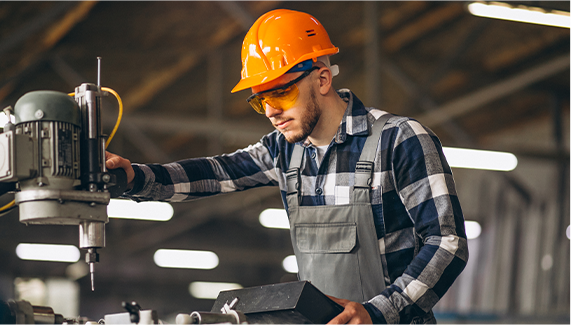
ASBWeb/ASBWeb/assets/img/david/david_1.png
