TheJonBovi/AutomatedSmartBlinds/ASBWeb/ASBWeb/assets/img/david/david_2.png

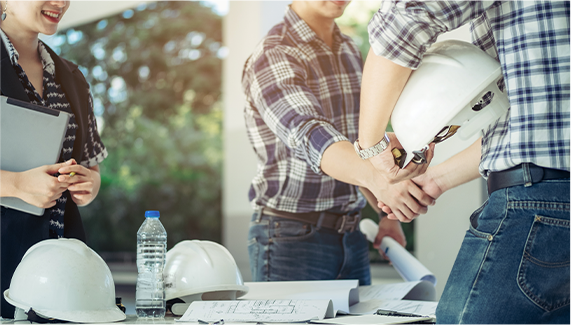
ASBWeb/ASBWeb/assets/img/david/david_2.png
