TheJonBovi/AutomatedSmartBlinds/ASBWeb/ASBWeb/assets/img/elements/a2.jpg

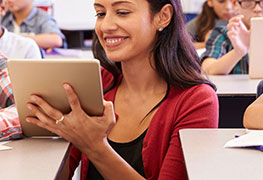
ASBWeb/ASBWeb/assets/img/elements/a2.jpg
