TheJonBovi/AutomatedSmartBlinds/ASBWeb/ASBWeb/assets/img/elements/a.jpg

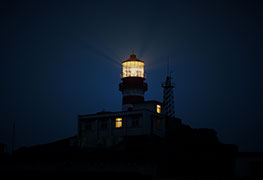
ASBWeb/ASBWeb/assets/img/elements/a.jpg
