TheJonBovi/AutomatedSmartBlinds/ASBWeb/ASBWeb/assets/img/elements/g1.jpg

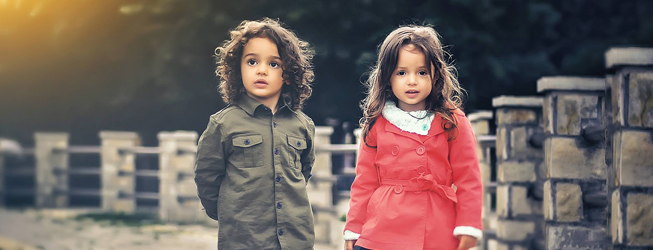
ASBWeb/ASBWeb/assets/img/elements/g1.jpg
