TheJonBovi/AutomatedSmartBlinds/ASBWeb/ASBWeb/assets/img/elements/g2.jpg

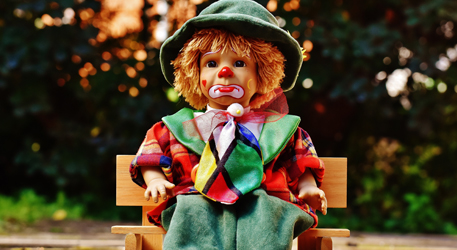
ASBWeb/ASBWeb/assets/img/elements/g2.jpg
