TheJonBovi/AutomatedSmartBlinds/ASBWeb/ASBWeb/assets/img/elements/g3.jpg

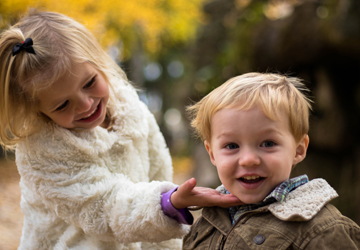
ASBWeb/ASBWeb/assets/img/elements/g3.jpg
