TheJonBovi/AutomatedSmartBlinds/ASBWeb/ASBWeb/assets/img/elements/g4.jpg

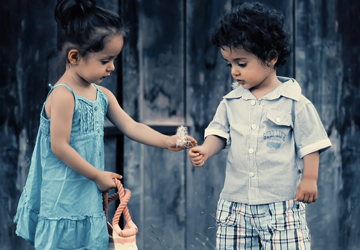
ASBWeb/ASBWeb/assets/img/elements/g4.jpg
