TheJonBovi/AutomatedSmartBlinds/ASBWeb/ASBWeb/assets/img/elements/g5.jpg

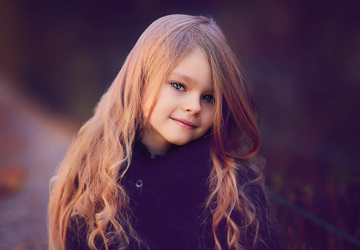
ASBWeb/ASBWeb/assets/img/elements/g5.jpg
