TheJonBovi/AutomatedSmartBlinds/ASBWeb/ASBWeb/assets/img/elements/g6.jpg

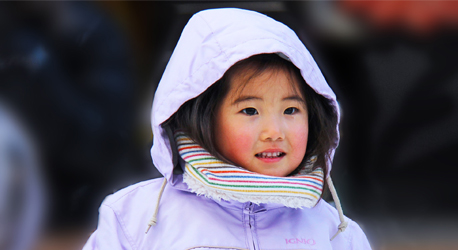
ASBWeb/ASBWeb/assets/img/elements/g6.jpg
