TheJonBovi/AutomatedSmartBlinds/ASBWeb/ASBWeb/assets/img/elements/g7.jpg

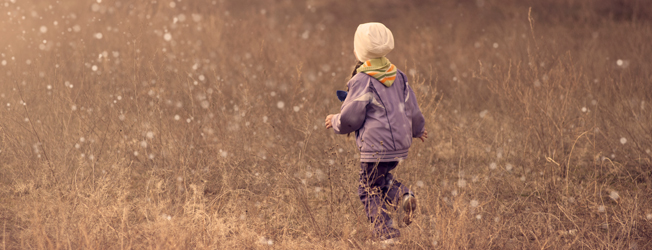
ASBWeb/ASBWeb/assets/img/elements/g7.jpg
