TheJonBovi/AutomatedSmartBlinds/ASBWeb/ASBWeb/assets/img/elements/g8.jpg

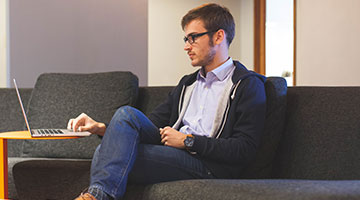
ASBWeb/ASBWeb/assets/img/elements/g8.jpg
