TheJonBovi/AutomatedSmartBlinds/ASBWeb/ASBWeb/assets/img/gallery/1.png

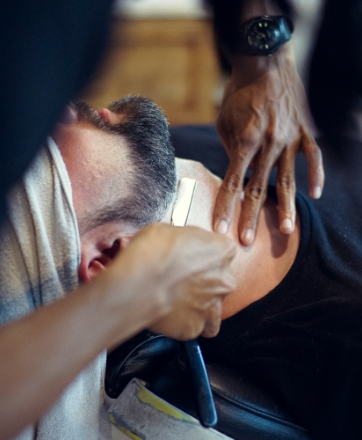
ASBWeb/ASBWeb/assets/img/gallery/1.png
