TheJonBovi/AutomatedSmartBlinds/ASBWeb/ASBWeb/assets/img/gallery/2.png

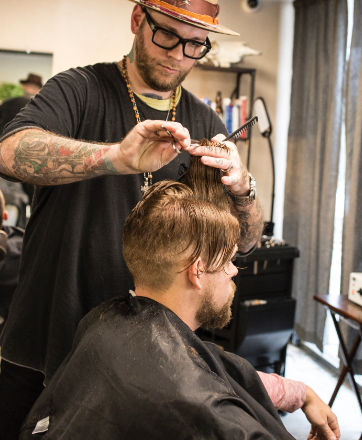
ASBWeb/ASBWeb/assets/img/gallery/2.png
