TheJonBovi/AutomatedSmartBlinds/ASBWeb/ASBWeb/assets/img/gallery/3.png

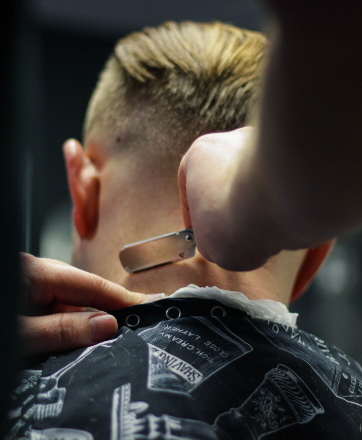
ASBWeb/ASBWeb/assets/img/gallery/3.png
