TheJonBovi/AutomatedSmartBlinds/ASBWeb/ASBWeb/assets/img/gallery/blinds-front-open.jpg

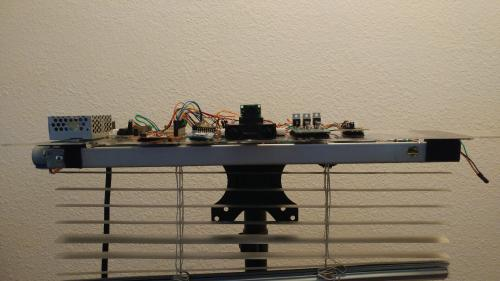
ASBWeb/ASBWeb/assets/img/gallery/blinds-front-open.jpg
