TheJonBovi/AutomatedSmartBlinds/ASBWeb/ASBWeb/assets/img/gallery/front-closed.jpg

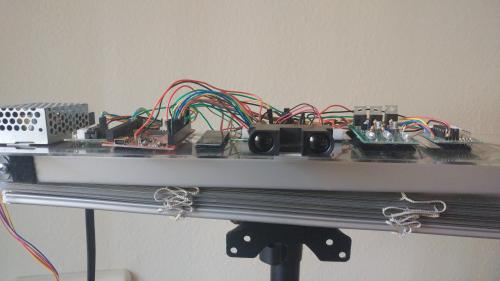
ASBWeb/ASBWeb/assets/img/gallery/front-closed.jpg
