TheJonBovi/AutomatedSmartBlinds/ASBWeb/ASBWeb/assets/img/gallery/front-down.jpg

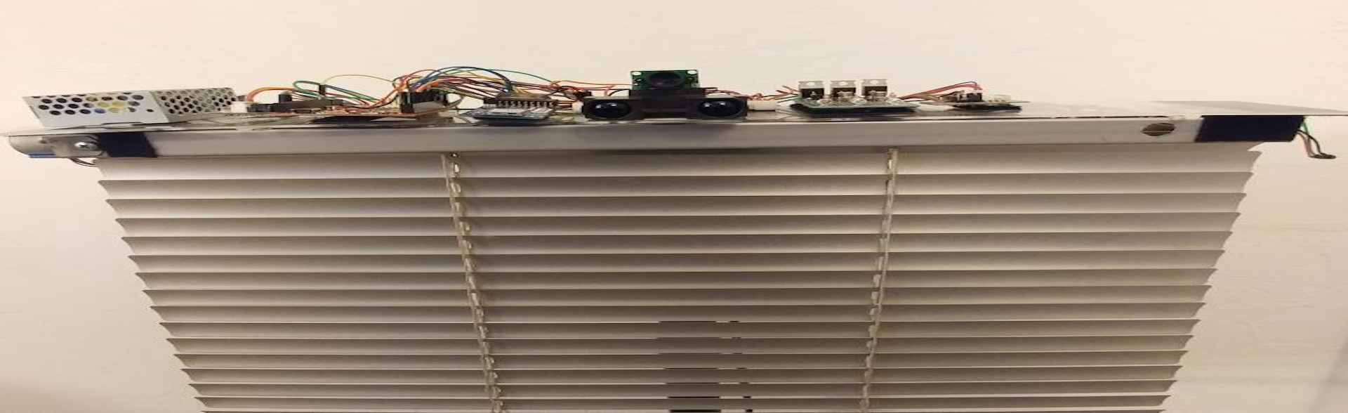
ASBWeb/ASBWeb/assets/img/gallery/front-down.jpg
