TheJonBovi/AutomatedSmartBlinds/ASBWeb/ASBWeb/assets/img/gallery/map-footer.png

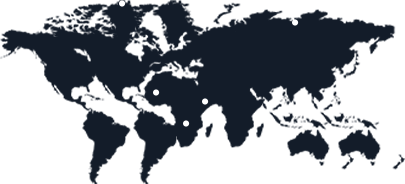
ASBWeb/ASBWeb/assets/img/gallery/map-footer.png
