TheJonBovi/AutomatedSmartBlinds/ASBWeb/ASBWeb/assets/img/gallery/project1.png

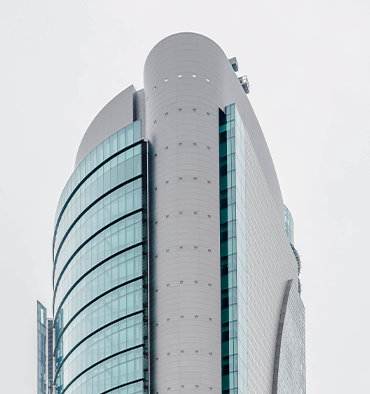
ASBWeb/ASBWeb/assets/img/gallery/project1.png
