TheJonBovi/AutomatedSmartBlinds/ASBWeb/ASBWeb/assets/img/gallery/project2.jpg

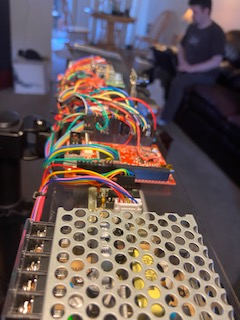
ASBWeb/ASBWeb/assets/img/gallery/project2.jpg
