TheJonBovi/AutomatedSmartBlinds/ASBWeb/ASBWeb/assets/img/gallery/project2.png

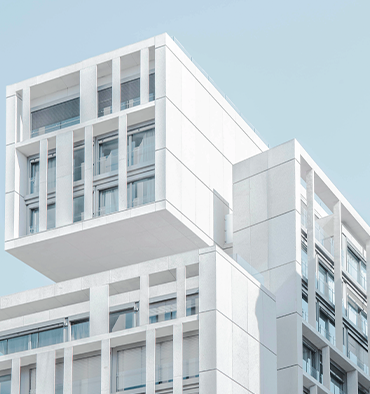
ASBWeb/ASBWeb/assets/img/gallery/project2.png
