TheJonBovi/AutomatedSmartBlinds/ASBWeb/ASBWeb/assets/img/gallery/project3.jpg

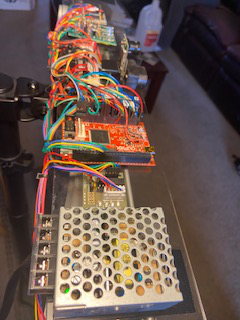
ASBWeb/ASBWeb/assets/img/gallery/project3.jpg
