TheJonBovi/AutomatedSmartBlinds/ASBWeb/ASBWeb/assets/img/gallery/project3.png

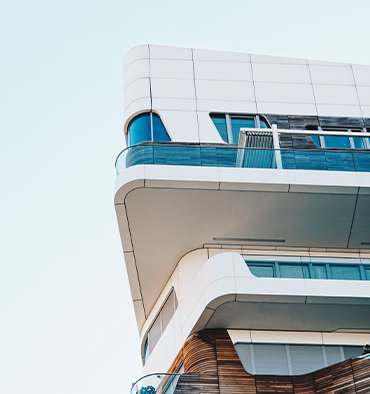
ASBWeb/ASBWeb/assets/img/gallery/project3.png
