TheJonBovi/AutomatedSmartBlinds/ASBWeb/ASBWeb/assets/img/gallery/project4.jpg

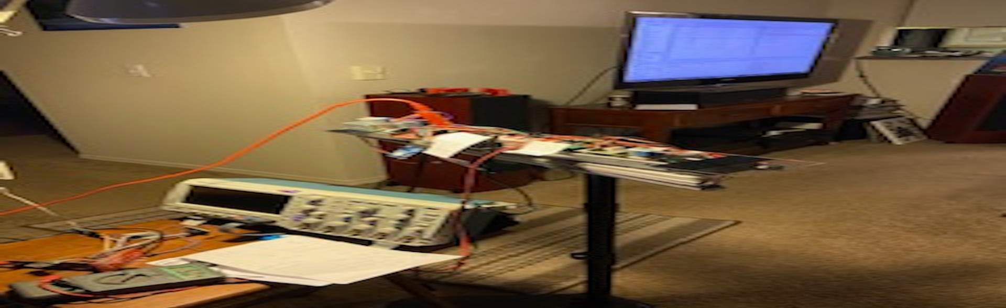
ASBWeb/ASBWeb/assets/img/gallery/project4.jpg
