TheJonBovi/AutomatedSmartBlinds/ASBWeb/ASBWeb/assets/img/gallery/project4.png

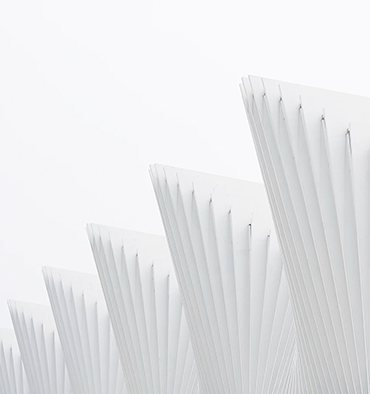
ASBWeb/ASBWeb/assets/img/gallery/project4.png
