TheJonBovi/AutomatedSmartBlinds/ASBWeb/ASBWeb/assets/img/gallery/project5.jpg

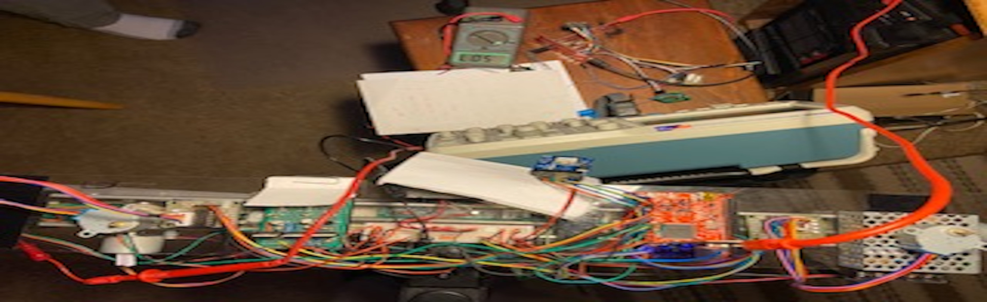
ASBWeb/ASBWeb/assets/img/gallery/project5.jpg
