TheJonBovi/AutomatedSmartBlinds/ASBWeb/ASBWeb/assets/img/gallery/project5.png

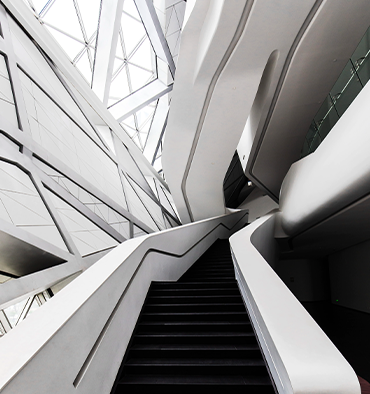
ASBWeb/ASBWeb/assets/img/gallery/project5.png
