TheJonBovi/AutomatedSmartBlinds/ASBWeb/ASBWeb/assets/img/gallery/project6.png

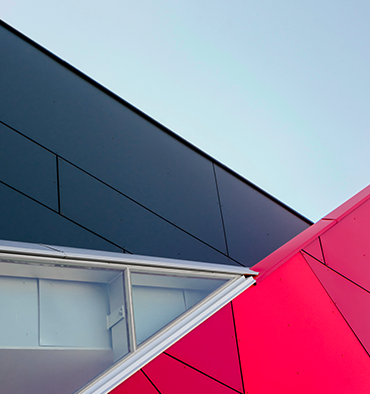
ASBWeb/ASBWeb/assets/img/gallery/project6.png
