TheJonBovi/AutomatedSmartBlinds/ASBWeb/ASBWeb/assets/img/gallery/project_details.jpg

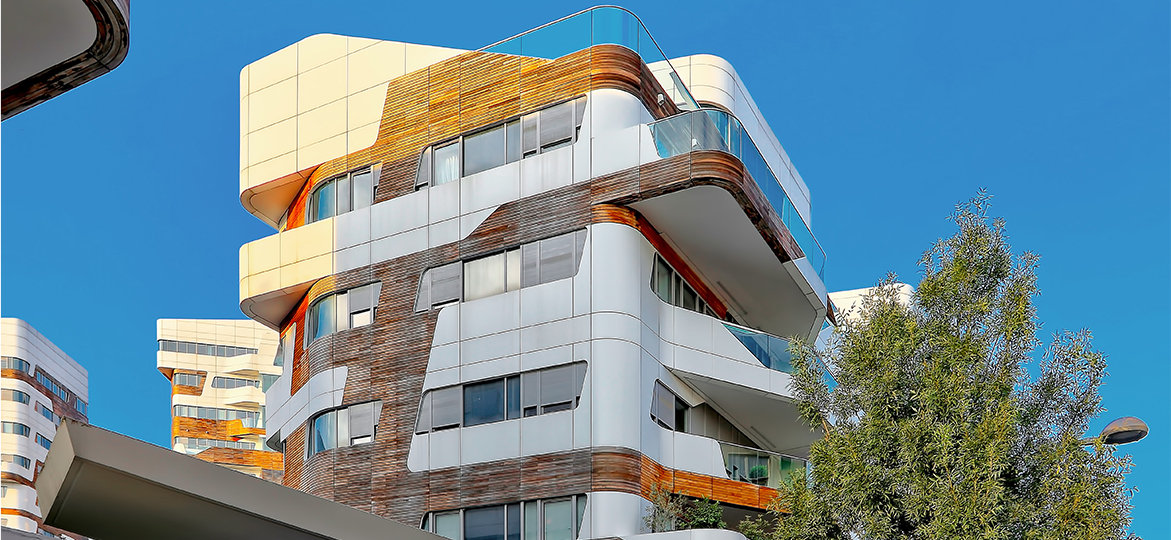
ASBWeb/ASBWeb/assets/img/gallery/project_details.jpg
