TheJonBovi/AutomatedSmartBlinds/ASBWeb/ASBWeb/assets/img/gallery/safe_in.png

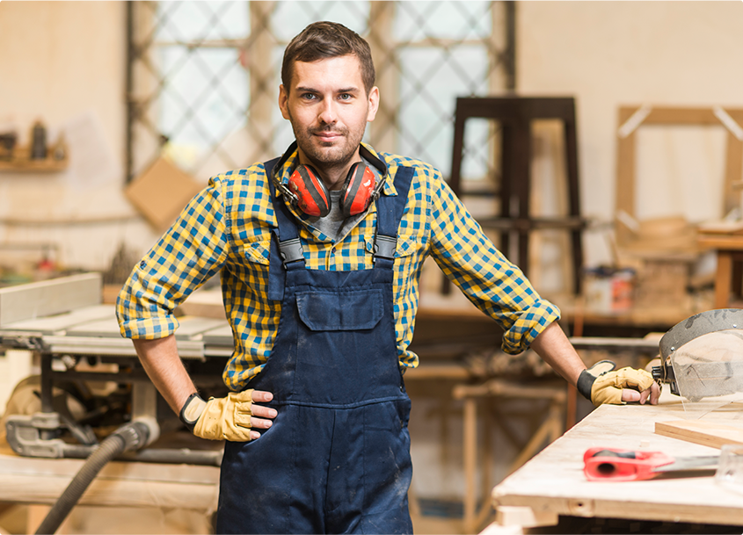
ASBWeb/ASBWeb/assets/img/gallery/safe_in.png
