TheJonBovi/AutomatedSmartBlinds/ASBWeb/ASBWeb/assets/img/gallery/services_details.png

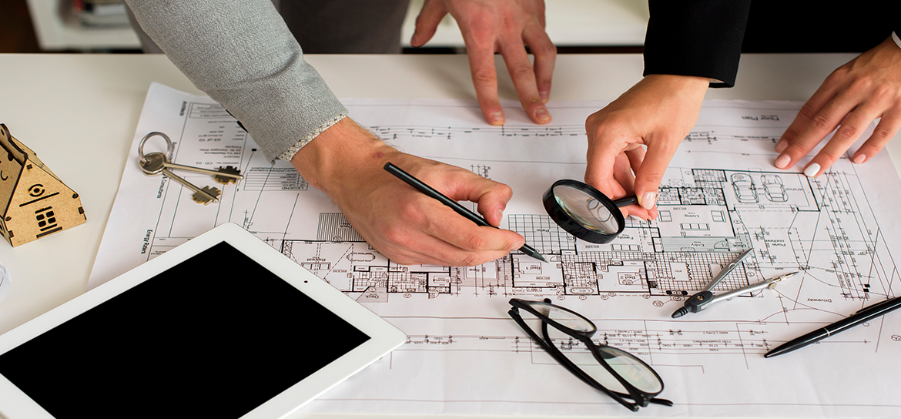
ASBWeb/ASBWeb/assets/img/gallery/services_details.png
