TheJonBovi/AutomatedSmartBlinds/ASBWeb/ASBWeb/assets/img/gallery/side-down-closed.jpg

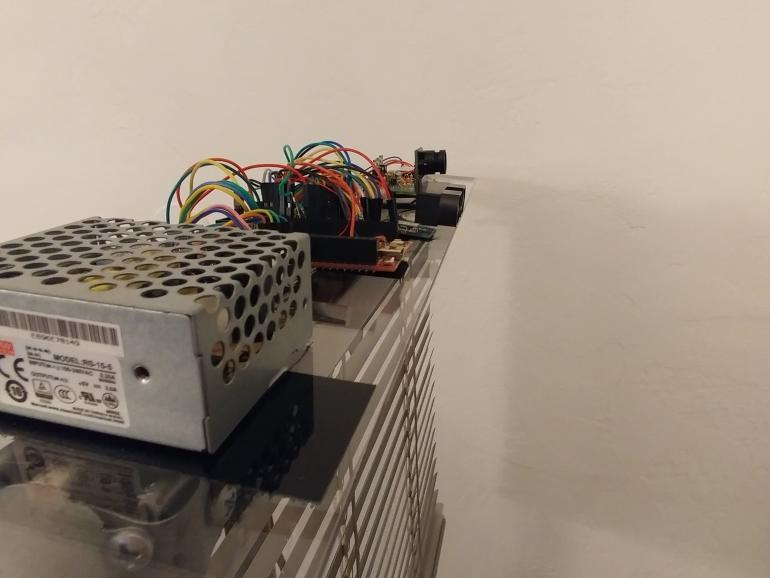
ASBWeb/ASBWeb/assets/img/gallery/side-down-closed.jpg
