TheJonBovi/AutomatedSmartBlinds/ASBWeb/ASBWeb/assets/img/gallery/side-front-view.png

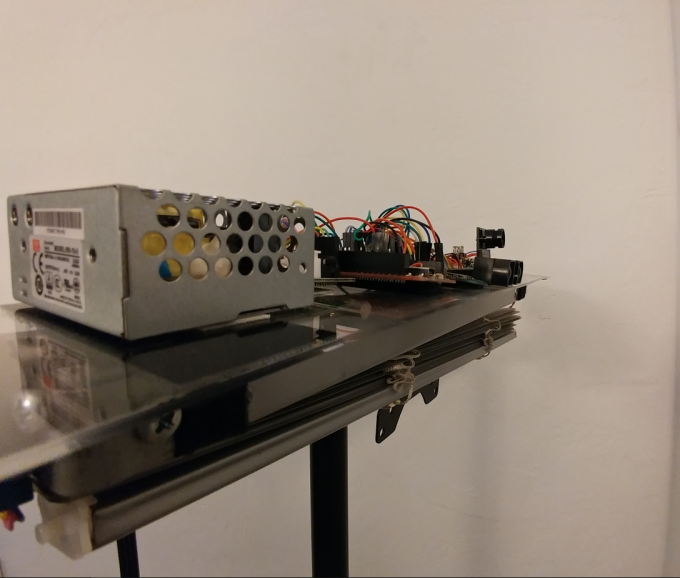
ASBWeb/ASBWeb/assets/img/gallery/side-front-view.png
