TheJonBovi/AutomatedSmartBlinds/ASBWeb/ASBWeb/assets/img/gallery/video.png

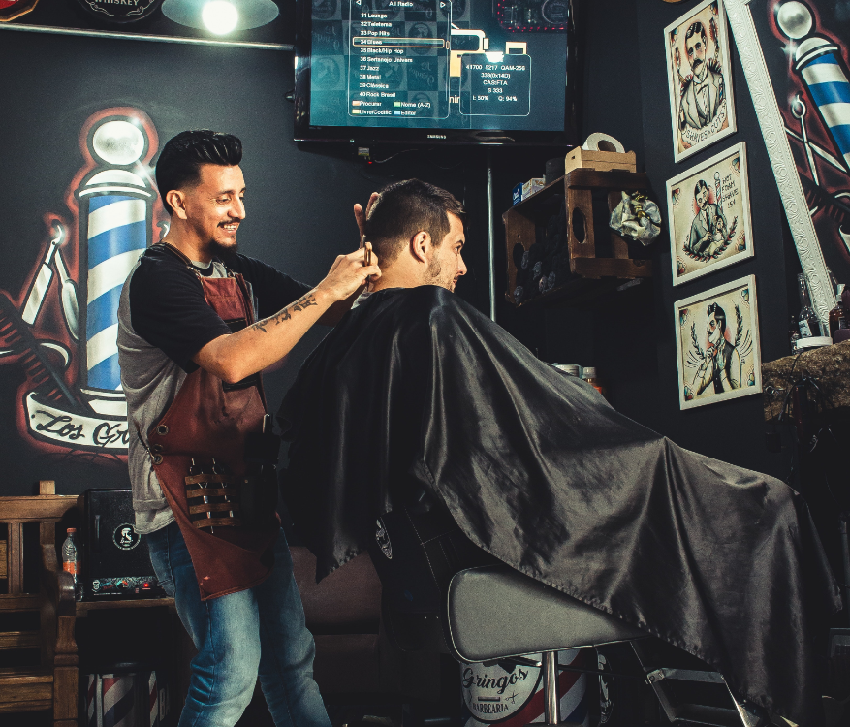
ASBWeb/ASBWeb/assets/img/gallery/video.png
