TheJonBovi/AutomatedSmartBlinds/ASBWeb/ASBWeb/assets/img/gallery/walleblinds.jpg

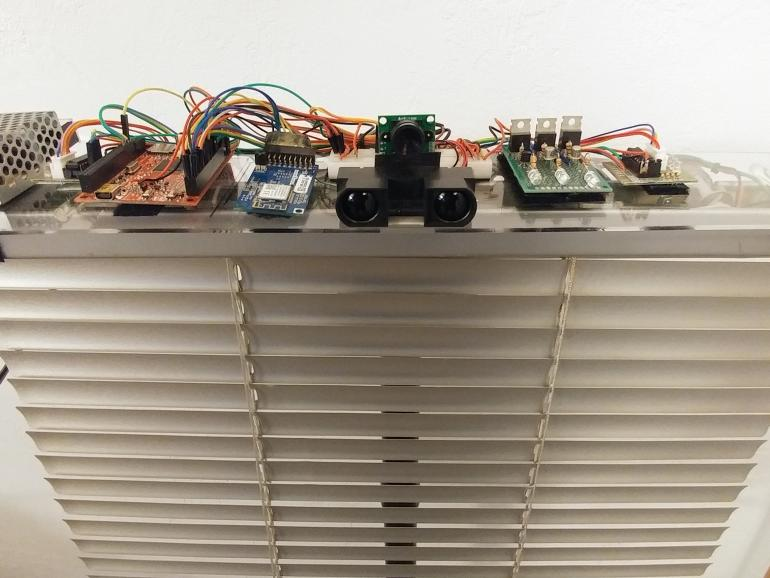
ASBWeb/ASBWeb/assets/img/gallery/walleblinds.jpg
