TheJonBovi/AutomatedSmartBlinds/ASBWeb/ASBWeb/assets/img/gallery/work_in_progress.jpg

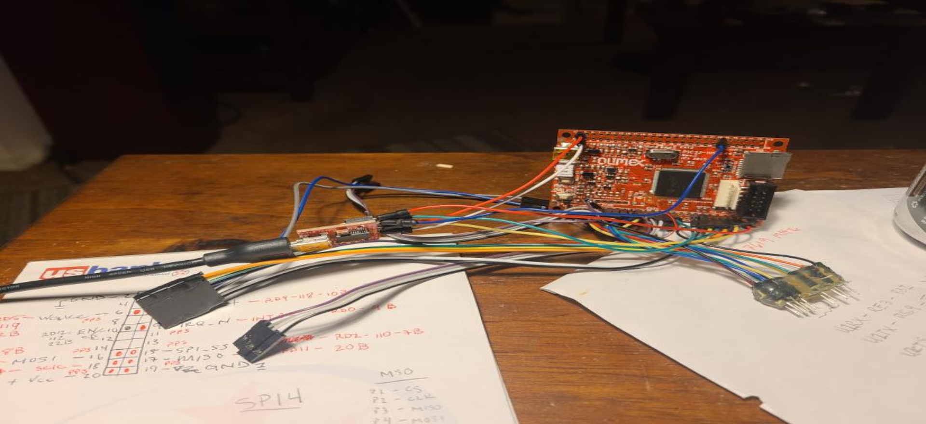
ASBWeb/ASBWeb/assets/img/gallery/work_in_progress.jpg
