TheJonBovi/AutomatedSmartBlinds/ASBWeb/ASBWeb/assets/img/hero/about.jpg

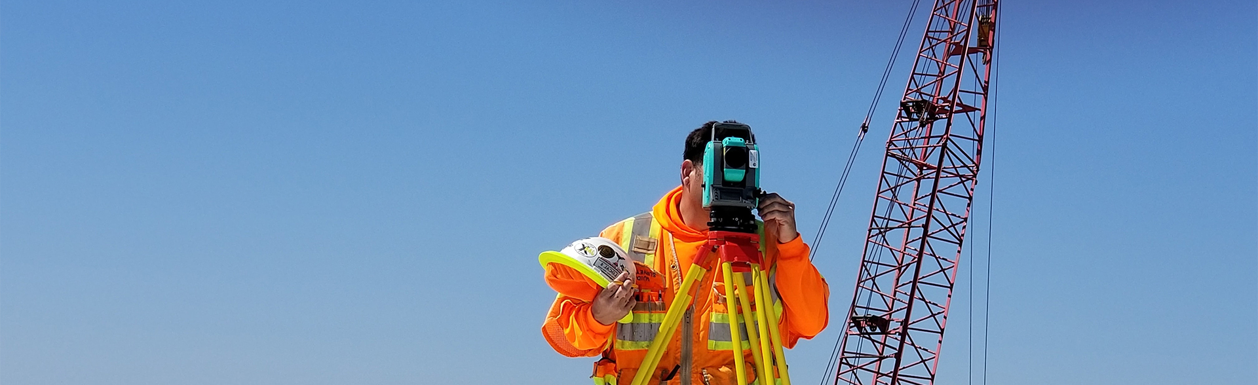
ASBWeb/ASBWeb/assets/img/hero/about.jpg
