TheJonBovi/AutomatedSmartBlinds/ASBWeb/ASBWeb/assets/img/hero/h1_hero.jpg

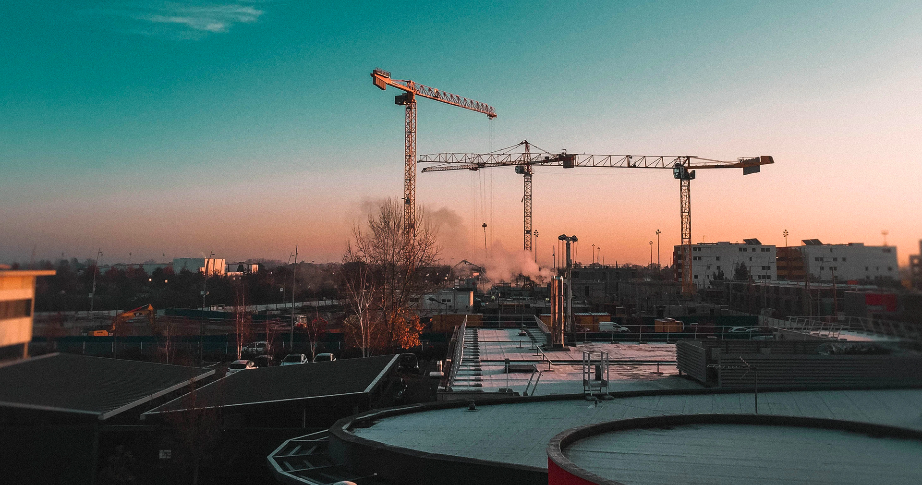
ASBWeb/ASBWeb/assets/img/hero/h1_hero.jpg
