TheJonBovi/AutomatedSmartBlinds/ASBWeb/ASBWeb/assets/img/offers/1.png

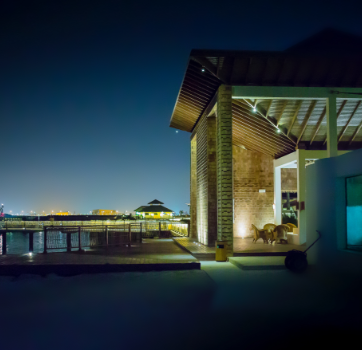
ASBWeb/ASBWeb/assets/img/offers/1.png
