TheJonBovi/AutomatedSmartBlinds/ASBWeb/ASBWeb/assets/img/offers/2.png

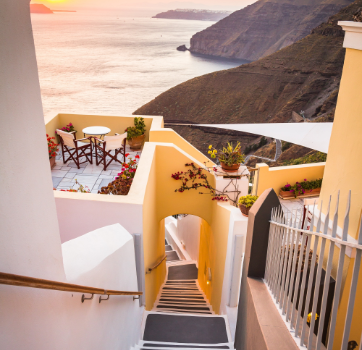
ASBWeb/ASBWeb/assets/img/offers/2.png
