TheJonBovi/AutomatedSmartBlinds/ASBWeb/ASBWeb/assets/img/offers/3.png

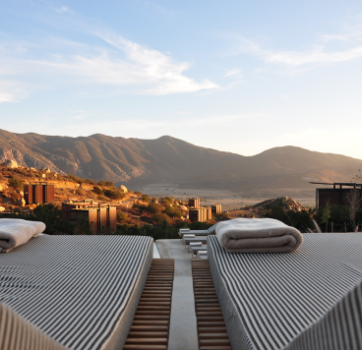
ASBWeb/ASBWeb/assets/img/offers/3.png
