TheJonBovi/AutomatedSmartBlinds/ASBWeb/ASBWeb/assets/img/our_blog/blog-img1.jpg

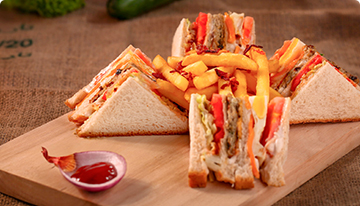
ASBWeb/ASBWeb/assets/img/our_blog/blog-img1.jpg
