TheJonBovi/AutomatedSmartBlinds/ASBWeb/ASBWeb/assets/img/service/1.png

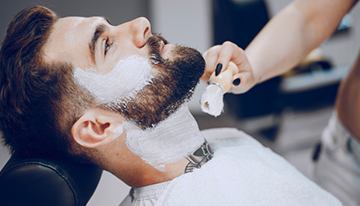
ASBWeb/ASBWeb/assets/img/service/1.png
