TheJonBovi/AutomatedSmartBlinds/ASBWeb/ASBWeb/assets/img/service/2.png

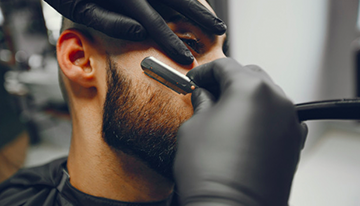
ASBWeb/ASBWeb/assets/img/service/2.png
