TheJonBovi/AutomatedSmartBlinds/ASBWeb/ASBWeb/assets/img/service/3.png

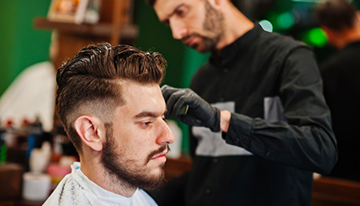
ASBWeb/ASBWeb/assets/img/service/3.png
