TheJonBovi/AutomatedSmartBlinds/ASBWeb/ASBWeb/assets/img/service/servicess1.png

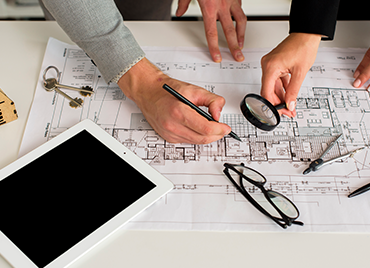
ASBWeb/ASBWeb/assets/img/service/servicess1.png
