TheJonBovi/AutomatedSmartBlinds/ASBWeb/ASBWeb/assets/img/service/servicess2.png

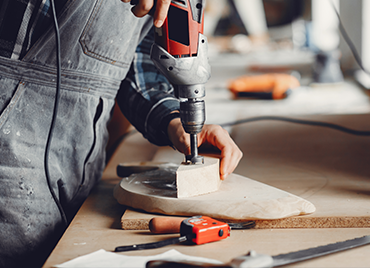
ASBWeb/ASBWeb/assets/img/service/servicess2.png
