TheJonBovi/AutomatedSmartBlinds/ASBWeb/ASBWeb/assets/img/service/servicess3.png

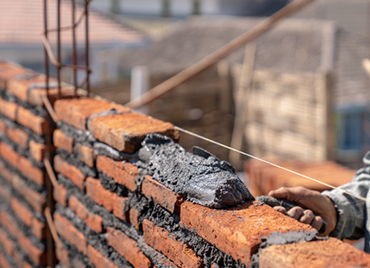
ASBWeb/ASBWeb/assets/img/service/servicess3.png
