TheJonBovi/AutomatedSmartBlinds/ASBWeb/ASBWeb/assets/img/service/servicess4.png

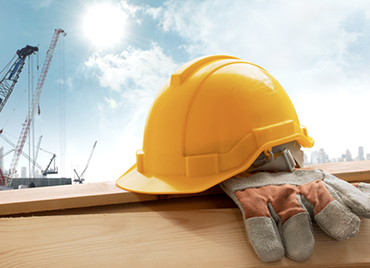
ASBWeb/ASBWeb/assets/img/service/servicess4.png
