TheJonBovi/AutomatedSmartBlinds/ASBWeb/ASBWeb/assets/img/service/servicess5.png

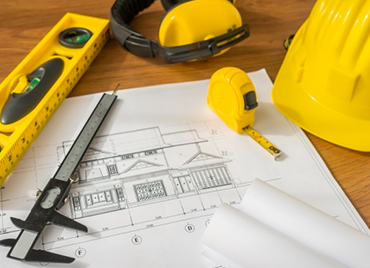
ASBWeb/ASBWeb/assets/img/service/servicess5.png
