TheJonBovi/AutomatedSmartBlinds/ASBWeb/ASBWeb/assets/img/service/servicess6.png

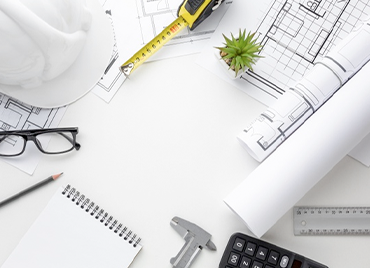
ASBWeb/ASBWeb/assets/img/service/servicess6.png
