TheJonBovi/AutomatedSmartBlinds/ASBWeb/ASBWeb/assets/img/team/1.png

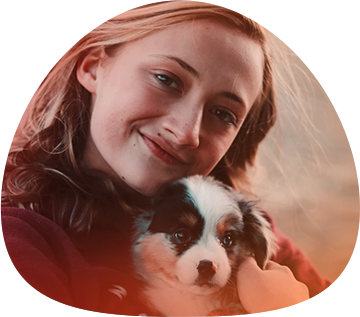
ASBWeb/ASBWeb/assets/img/team/1.png
