TheJonBovi/AutomatedSmartBlinds/ASBWeb/ASBWeb/assets/img/team/2.png

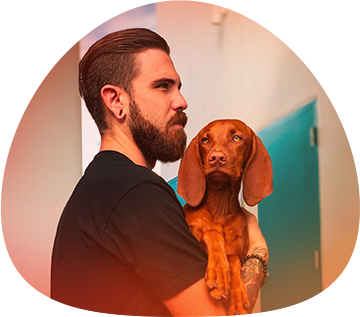
ASBWeb/ASBWeb/assets/img/team/2.png
