TheJonBovi/AutomatedSmartBlinds/ASBWeb/ASBWeb/assets/img/team/3.png

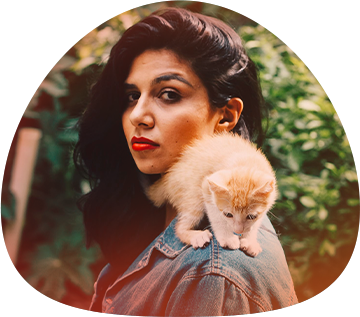
ASBWeb/ASBWeb/assets/img/team/3.png
