TheJonBovi/AutomatedSmartBlinds/ASBWeb/ASBWeb/assets/img/team/chad.jpg

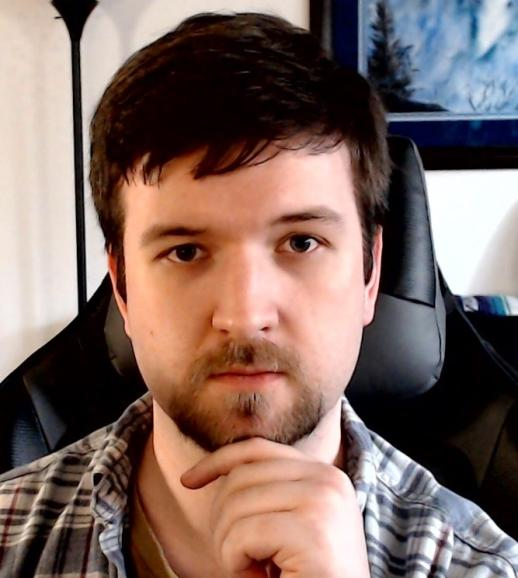
ASBWeb/ASBWeb/assets/img/team/chad.jpg
