TheJonBovi/AutomatedSmartBlinds/ASBWeb/ASBWeb/assets/img/team/Drew.jpg

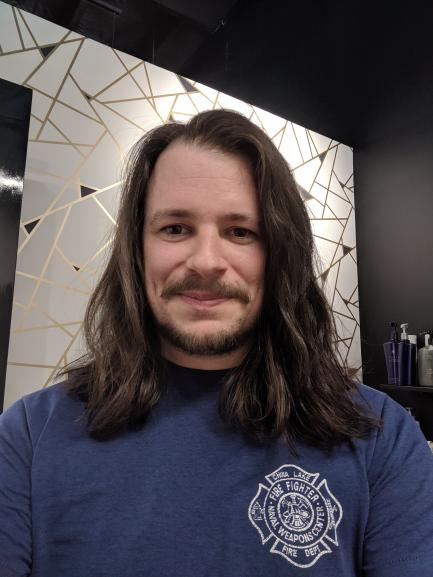
ASBWeb/ASBWeb/assets/img/team/Drew.jpg
