TheJonBovi/AutomatedSmartBlinds/ASBWeb/ASBWeb/assets/img/team/Drew_3.jpg

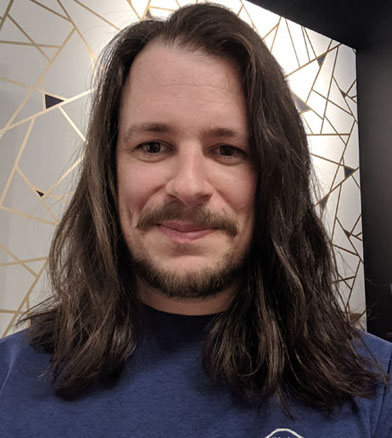
ASBWeb/ASBWeb/assets/img/team/Drew_3.jpg
