TheJonBovi/AutomatedSmartBlinds/ASBWeb/ASBWeb/assets/img/team/Michael.png

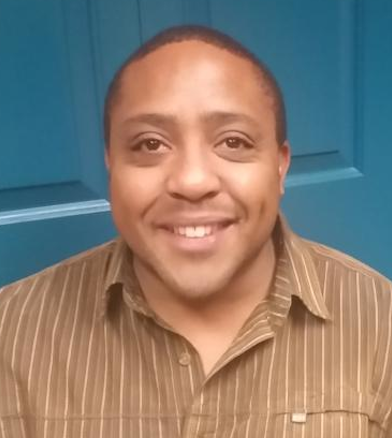
ASBWeb/ASBWeb/assets/img/team/Michael.png
