TheJonBovi/AutomatedSmartBlinds/ASBWeb/ASBWeb/assets/img/team/team1.png

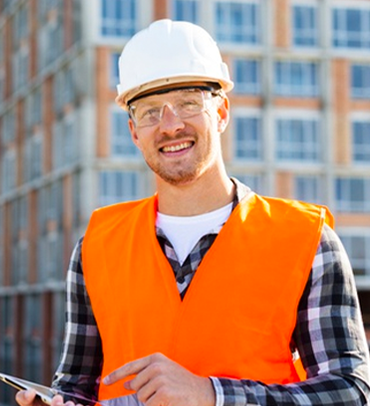
ASBWeb/ASBWeb/assets/img/team/team1.png
