TheJonBovi/AutomatedSmartBlinds/ASBWeb/ASBWeb/assets/img/team/team2.png

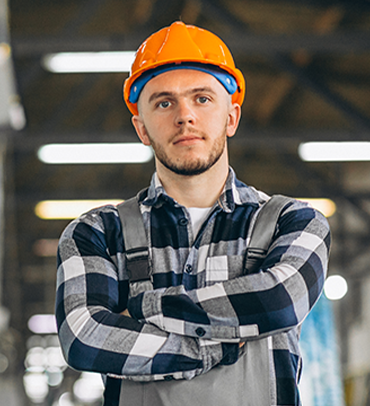
ASBWeb/ASBWeb/assets/img/team/team2.png
