TheJonBovi/AutomatedSmartBlinds/ASBWeb/ASBWeb/assets/img/team/team3.png

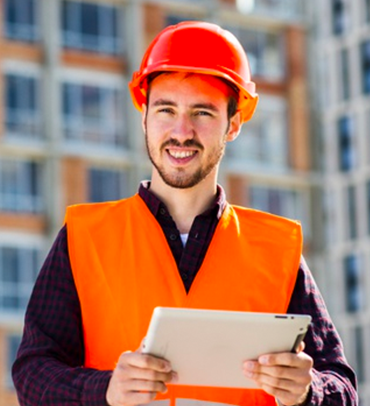
ASBWeb/ASBWeb/assets/img/team/team3.png
