TheJonBovi/AutomatedSmartBlinds/images/1200px-Oregon_Institute_of_Technology_seal.svg.png

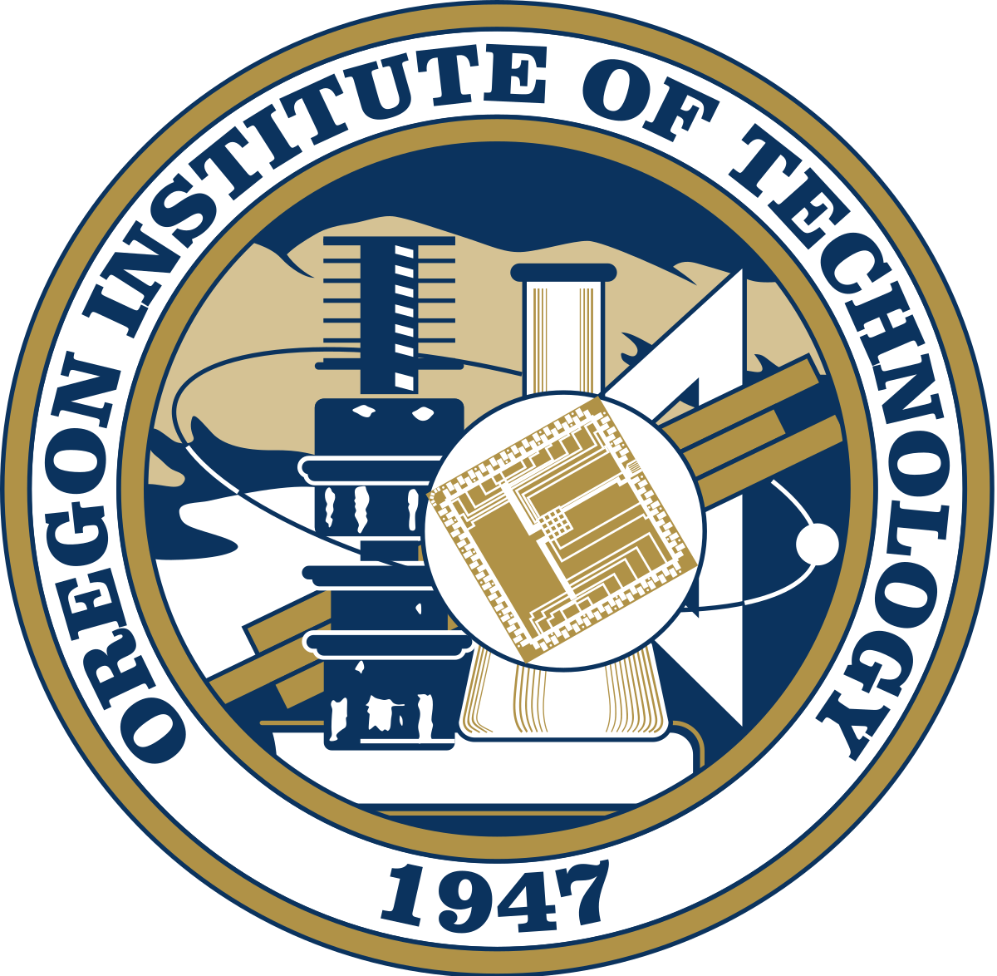
images/1200px-Oregon_Institute_of_Technology_seal.svg.png
