TheJonBovi/AutomatedSmartBlinds/images/reset_button.jpg

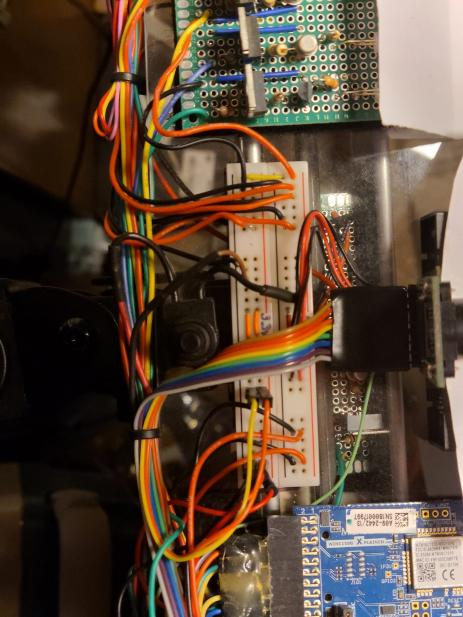
images/reset_button.jpg
