TheJonBovi/AutomatedSmartBlinds/images/T2presentation_meme.png

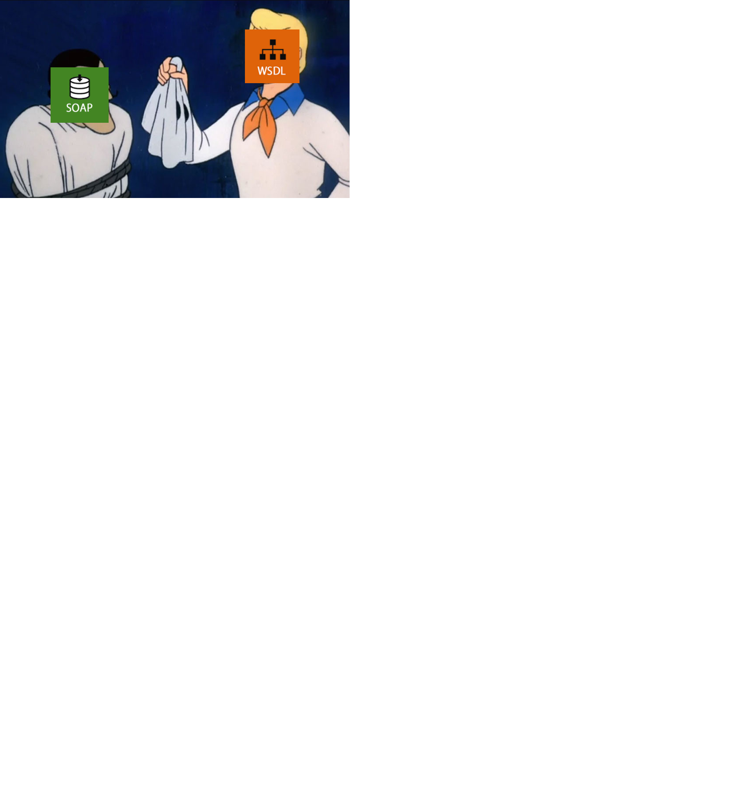
images/T2presentation_meme.png
