TheJonBovi/AutomatedSmartBlinds/schematics/images_for_presentation/motor_sub_module.png

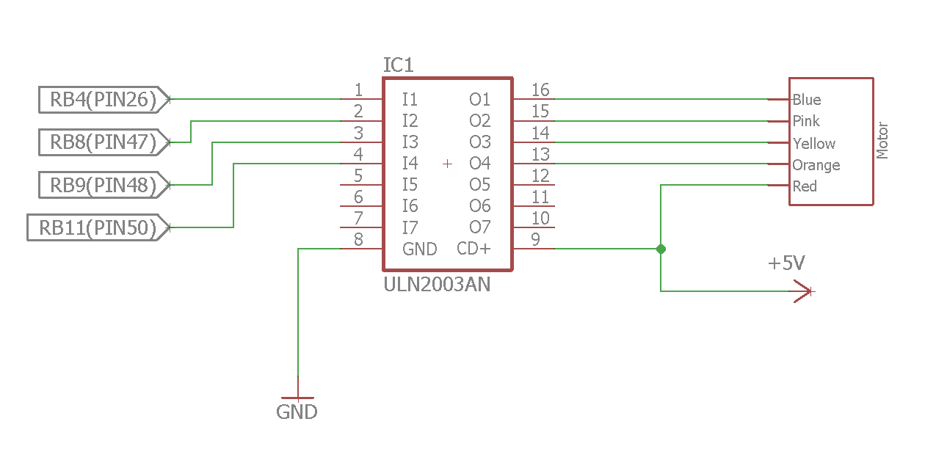
schematics/images_for_presentation/motor_sub_module.png
