TheJonBovi/AutomatedSmartBlinds/schematics/images_for_presentation/power_sub_module.png

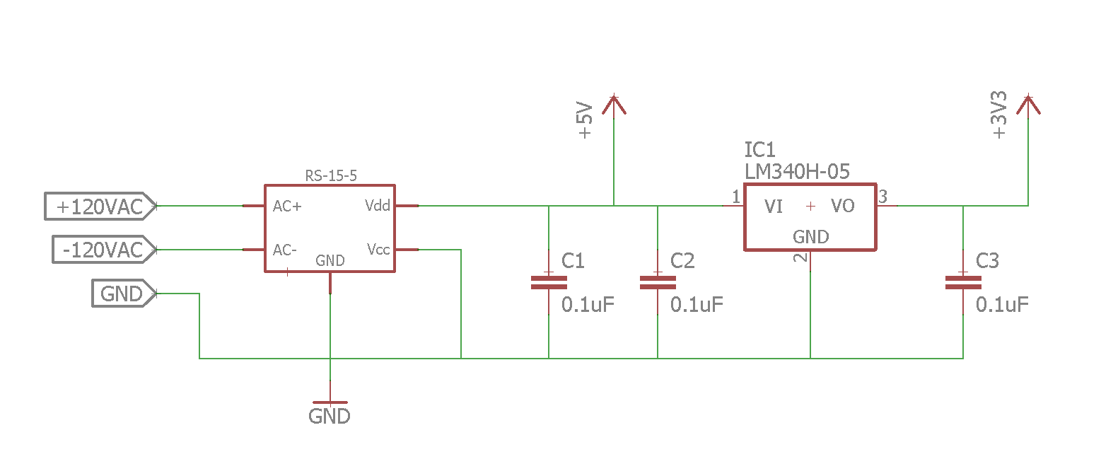
schematics/images_for_presentation/power_sub_module.png
