TheJonBovi/AutomatedSmartBlinds/schematics/images_for_presentation/wifi_sub_module2.png

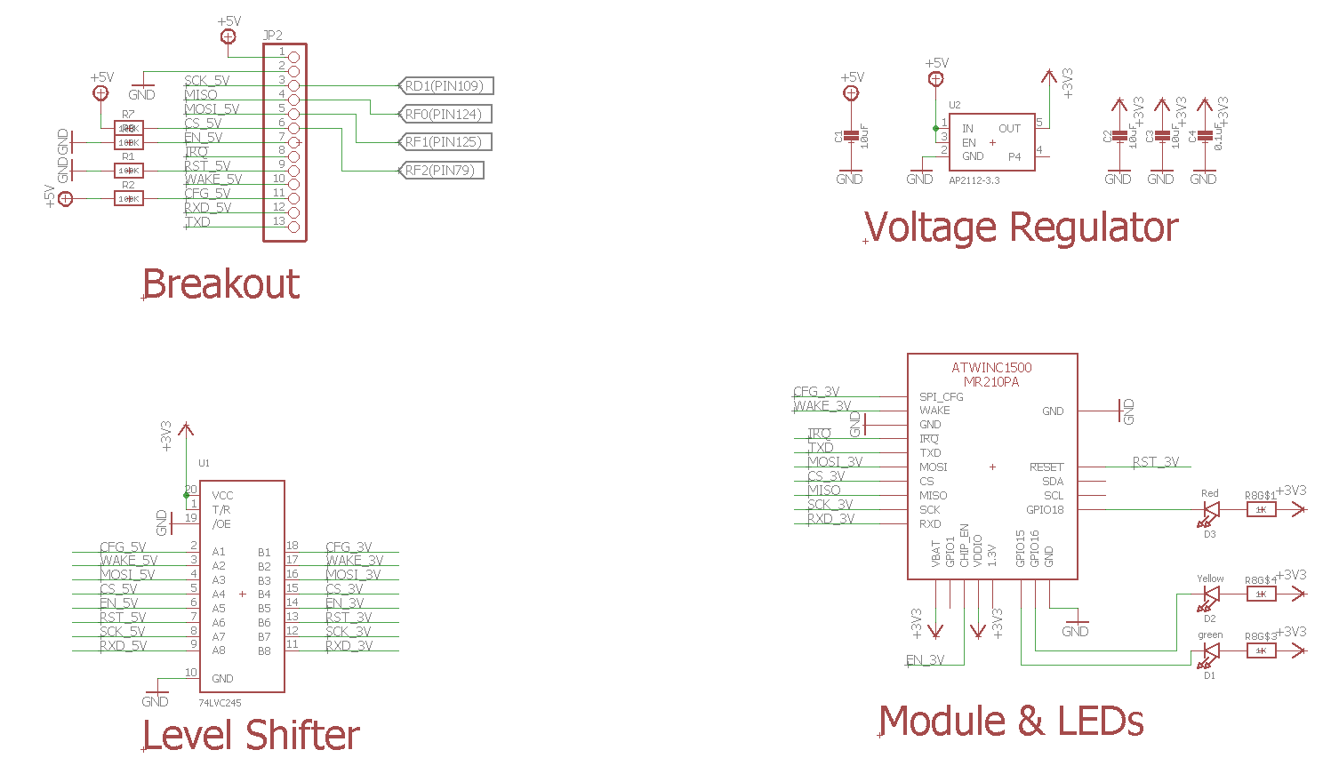
schematics/images_for_presentation/wifi_sub_module2.png
