TheJonBovi/AutomatedSmartBlinds/secondTermPresentation/Blinds final.PNG

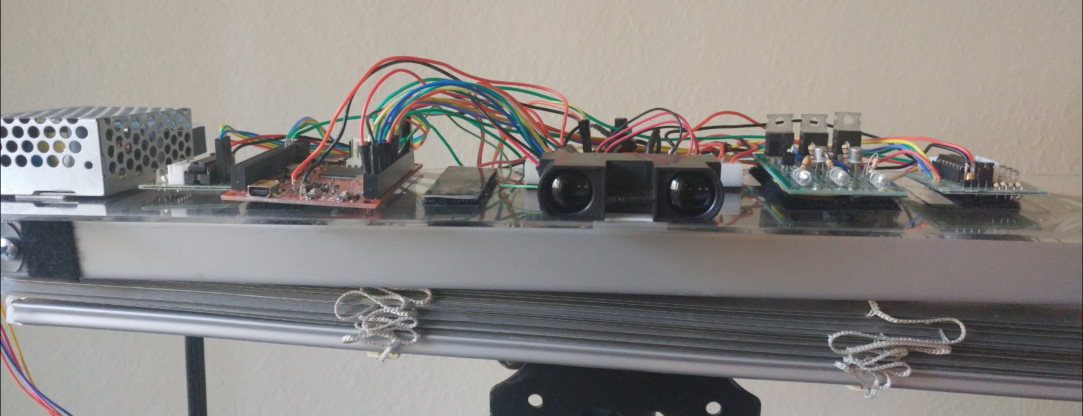
secondTermPresentation/Blinds final.PNG
