TheJonBovi/AutomatedSmartBlinds/secondTermPresentation/final LEDs.PNG

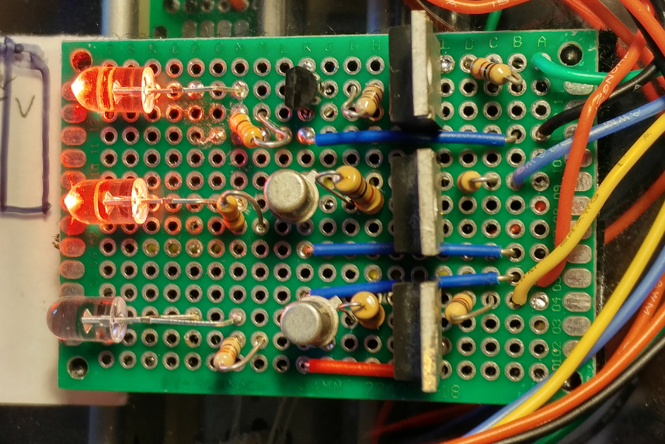
secondTermPresentation/final LEDs.PNG
