TheJonBovi/AutomatedSmartBlinds/secondTermPresentation/Gannt Chart Presentation.PNG

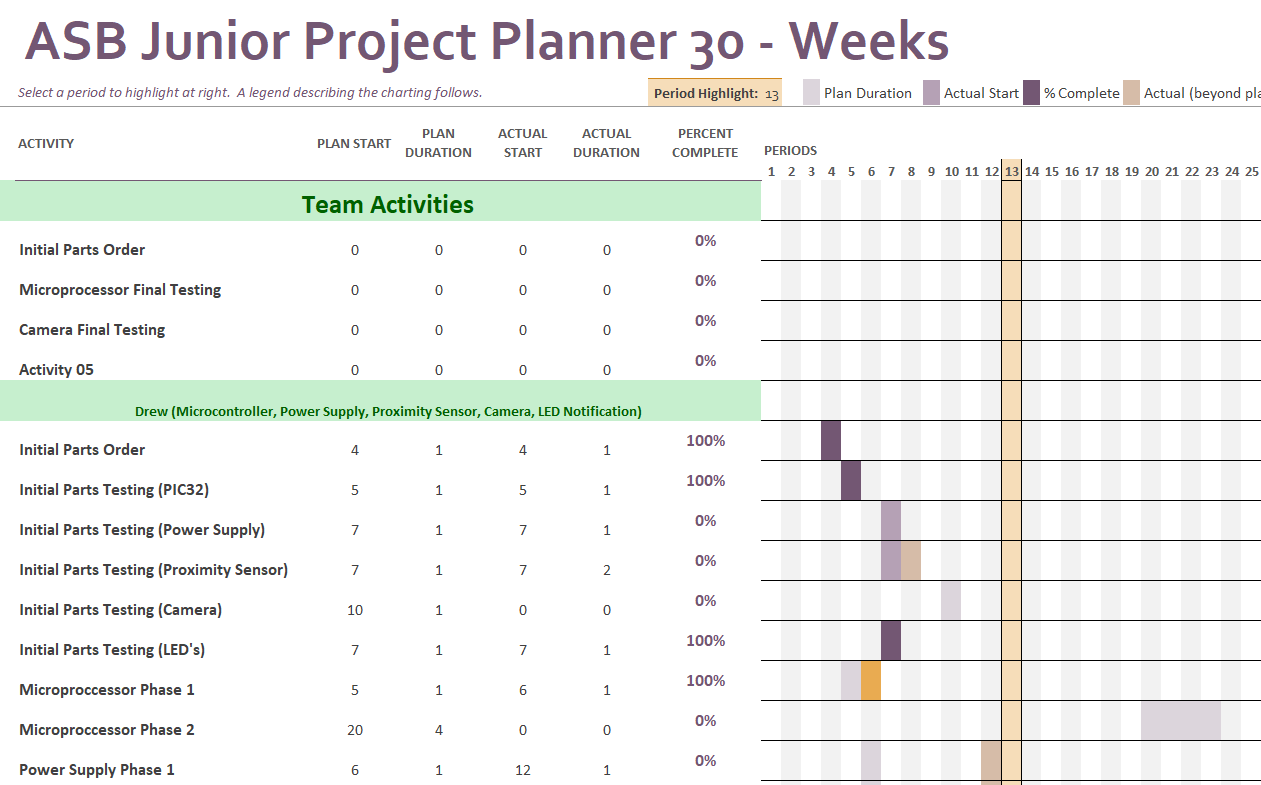
secondTermPresentation/Gannt Chart Presentation.PNG
