TheJonBovi/AutomatedSmartBlinds/secondTermPresentation/Motor and Shaft.PNG

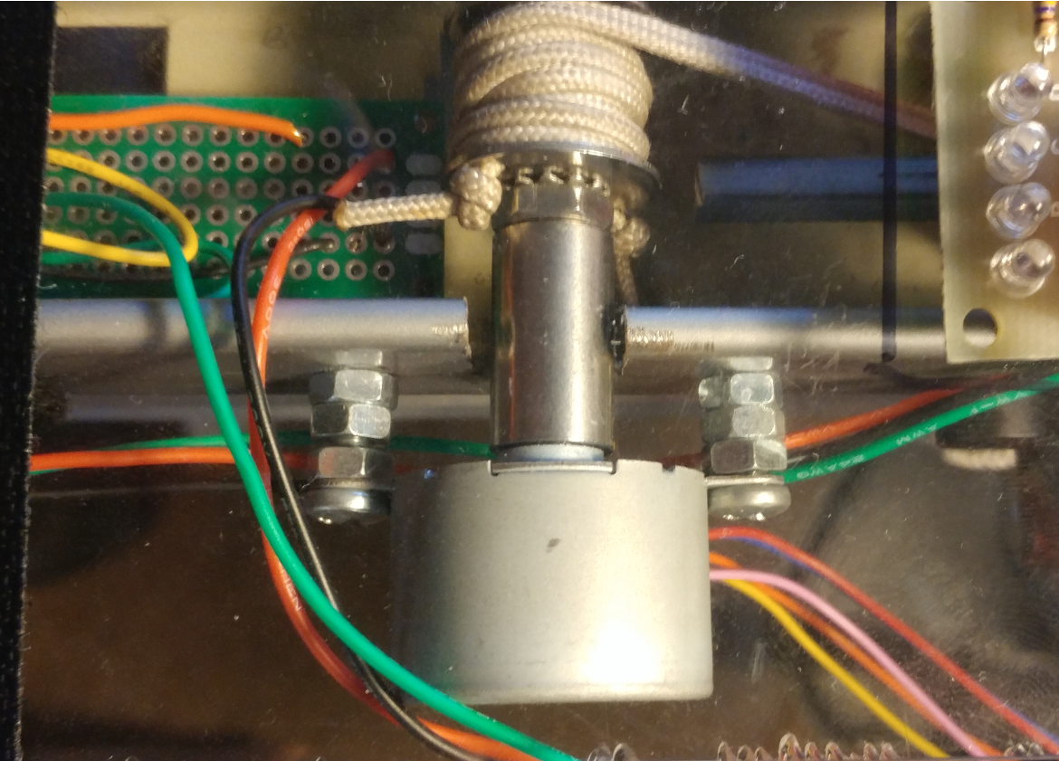
secondTermPresentation/Motor and Shaft.PNG
