TheJonBovi/AutomatedSmartBlinds/secondTermPresentation/Motor Shaft Coupler.PNG

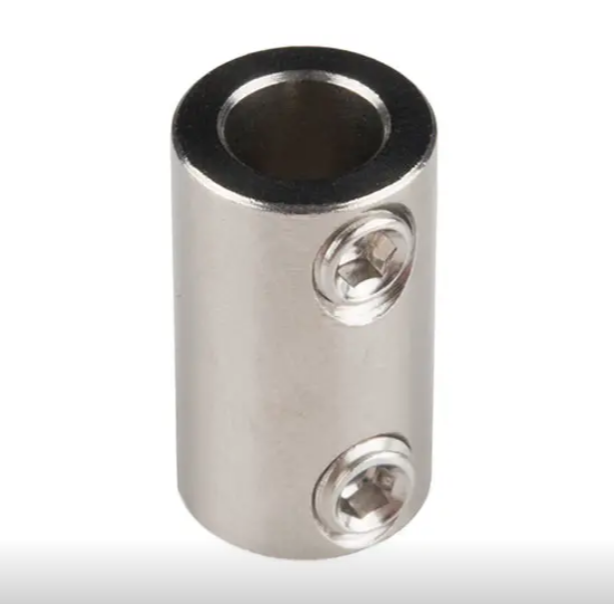
secondTermPresentation/Motor Shaft Coupler.PNG
