TheJonBovi/AutomatedSmartBlinds/secondTermPresentation/New Speaker.PNG

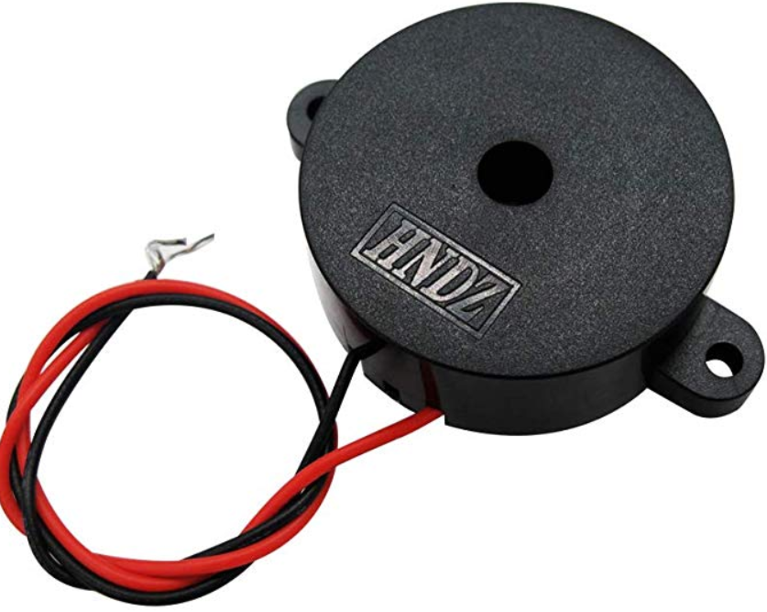
secondTermPresentation/New Speaker.PNG
