TheJonBovi/AutomatedSmartBlinds/secondTermPresentation/pic32 wire 1.PNG

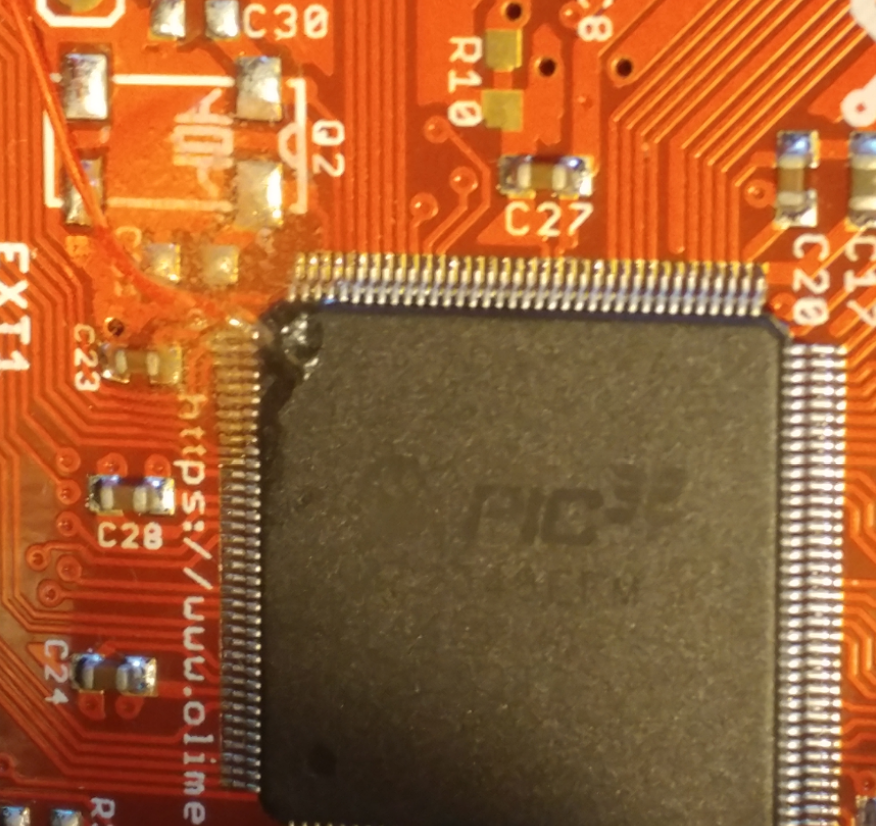
secondTermPresentation/pic32 wire 1.PNG
