TheJonBovi/AutomatedSmartBlinds/simulations/attenuation_circuit.asc

R1: res; 500
R2: res; 1000
V1: voltage; SINE(2.5 2.5 1k)
Named nets: 0, Vo, Vin
.tran 0 3ms 0
