TheJonBovi/AutomatedSmartBlinds/Simulations/5vto3vOpAmpCircuit.asc

R1: res; 1000
R2: res; 660
U1: LT1638
V1: voltage; 10
V2: voltage; 10
V3: voltage; SINE(2.5 2.5 100)
Named nets: 5V, VIN, -5V, V0, 0
.tran 0 100ms 0
