TheJonBovi/AutomatedSmartBlinds/schematics/Eagle/wifi_sub_module/adafruid_breakout.brd

## EAGLE design schematics/Eagle/wifi_sub_module/adafruid_breakout.brd (2019-11-18)

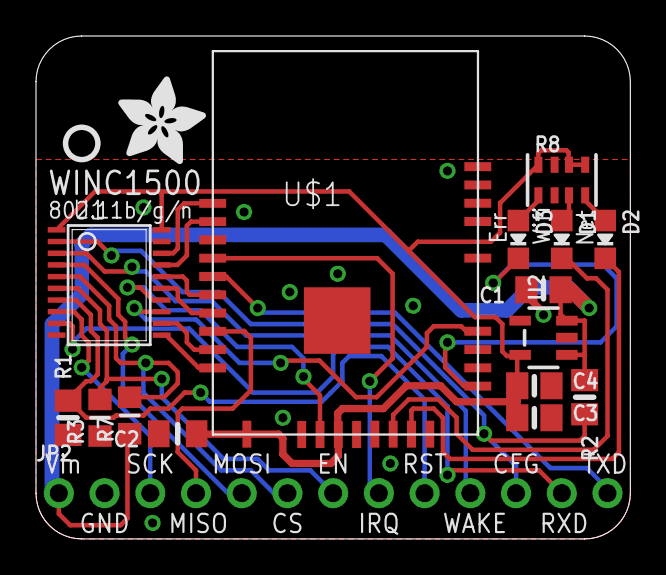
[picture p184: board adafruid_breakout.brd from above]

Board: 2 copper layers, 33.0 x 27.9 mm, 19 parts (1 on the bottom side), 28 nets.

Parts:
C1, C3: 10uF; 0805-NO
C2: 10uF; 0805_10MGAP
C4: 0.1uF; 0805-NO
D1: green; CHIPLED_0805_NOOUTLINE
D2: Yellow; CHIPLED_0805_NOOUTLINE
D3: Red; CHIPLED_0805_NOOUTLINE
JP2: 1X13_ROUND_70
R1, R2: 100K; 0805-NO
R3, R7: 100K; _0805MP
R8: 1K; RESPACK_4X0603
U1: 74LVC245; TSSOP20
U2: AP2112-3.3; SOT23-5
U$1: ATWINC1500_MR210PB; ATWINC1500_MR210PA
U$4: ADAFRUIT_5MM
U$5: PCBFEAT-REV-040
U$6: ADAFRUIT_TEXT_20MM

Connections:
!IRQ: JP2.8, U$1.J13
+3V3: C2.1, C3.1, C4.1, R8.5, R8.6, R8.8, U1.1, U1.20, U2.5, U$1.J20, U$1.J23
+5V: C1.1, JP2.1, R2.1, R7.1, U2.1, U2.3
CFG_3V: U1.18, U$1.J10
CFG_5V: JP2.11, R2.2, U1.2
CS_3V: U1.15, U$1.J16
CS_5V: JP2.6, R7.2, U1.5
EN_3V: U1.14, U$1.J22
EN_5V: JP2.7, R3.2, U1.6
GND: C1.2, C2.2, C3.2, C4.2, JP2.2, R1.1, R3.1, U1.10, U1.19, U2.2, U$1.J9, U$1.J12, U$1.J28, U$1.MTGND
GPIO15: D1.C, U$1.J26
GPIO16: D2.C, U$1.J27
GPIO18: D3.C, U$1.J1
MISO: JP2.4, U$1.J17
MOSI_3V: U1.16, U$1.J15
MOSI_5V: JP2.5, U1.4
unnamed: D3.A, R8.1
unnamed: D2.A, R8.4
unnamed: D1.A, R8.3
RST_3V: U1.13, U$1.J4
RST_5V: JP2.9, R1.2, U1.7
RXD_3V: U1.11, U$1.J19
RXD_5V: JP2.12, U1.9
SCK_3V: U1.12, U$1.J18
SCK_5V: JP2.3, U1.8
TXD: JP2.13, U$1.J14
WAKE_3V: U1.17, U$1.J11
WAKE_5V: JP2.10, U1.3
