TheJonBovi/AutomatedSmartBlinds/PIC32/EFG(new)/SmartBlinds.X/stubs/wf_mcu_driver_stub.c

/*==============================================================================
Copyright 2016 Microchip Technology Inc.

Licensed under the Apache License, Version 2.0 (the "License");
you may not use this file except in compliance with the License.
You may obtain a copy of the License at

    http://www.apache.org/licenses/LICENSE-2.0

Unless required by applicable law or agreed to in writing, software
distributed under the License is distributed on an "AS IS" BASIS,
WITHOUT WARRANTIES OR CONDITIONS OF ANY KIND, either express or implied.
See the License for the specific language governing permissions and
limitations under the License.
==============================================================================*/

#include "mcc.h"
#include "winc1500_api.h"

uint32_t GetOneMsCounter(void); 

#define WaitForDataByte()   while ((SPI4STATbits.SPITBF == 1) || (SPI4STATbits.SPIRBF == 0))

#if defined(USING_PICTAIL)
void m2mStub_PinSet_CE(t_m2mWifiPinAction action)
{
    if (action == M2M_WIFI_PIN_LOW)
    {
        IO_RG1_CE_SetLow();
    }
    else
    {
        IO_RG1_CE_SetHigh();
    }
}

void m2mStub_PinSet_RESET(t_m2mWifiPinAction action)
{
    if (action == M2M_WIFI_PIN_LOW)
    {
        IO_RD4_RESET_SetLow();
    }
    else
    {
        IO_RD4_RESET_SetHigh();
    }
}
#elif defined(USING_CLICK_BOARD)
void m2mStub_PinSet_CE(t_m2mWifiPinAction action)
{
    if (action == M2M_WIFI_PIN_LOW)
    {
        IO_RD12_CE_SetLow();
    }
    else
    {
        IO_RD12_CE_SetHigh();
    }
}

void m2mStub_PinSet_RESET(t_m2mWifiPinAction action)
{
    if (action == M2M_WIFI_PIN_LOW)
    {
        IO_RG14_RESET_SetLow();
    }
    else
    {
        IO_RG14_RESET_SetHigh();
    }
}


#endif


void m2mStub_PinSet_SPI_SS(t_m2mWifiPinAction action)
{
     if (action == M2M_WIFI_PIN_LOW)
    {
        IO_RD2_SS2_SetLow();
    }
    else
    {
        IO_RD2_SS2_SetHigh();
    }
}

uint32_t m2mStub_GetOneMsTimer(void)
{
    return GetOneMsCounter();   // function added to MCC generated timer1 code
}

void m2mStub_EintEnable(void)
{
    EX_INT0_InterruptEnable();  
}

void m2mStub_EintDisable(void)
{
    EX_INT0_InterruptDisable();
}

/*******************************************************************************
  Function:
    void m2mStub_SpiTxRx(void)

  Summary:
    Transmits and receives SPI bytes

  Description:
    Transmits and receives N bytes of SPI data.

  Precondition:
    None

  Parameters:
    p_txBuf - pointer to SPI tx data
    txLen   - number of bytes to Tx
    p_rxBuf - pointer to where SPI rx data will be stored
    rxLen   - number of SPI rx bytes caller wants copied to p_rxBuf

  Returns:
    None

  Remarks:
    Will clock out the larger of txLen or rxLen, and pad if necessary.
 *******************************************************************************/
void m2mStub_SpiTxRx(uint8_t *p_txBuf,
                    uint16_t txLen,
                    uint8_t *p_rxBuf,
                    uint16_t rxLen)
{
    uint16_t byteCount;
    uint16_t i;
    
    /* total number of byte to clock is whichever is larger, txLen or rxLen */
    byteCount = (txLen >= rxLen) ? txLen : rxLen;

    for (i = 0; i < byteCount; ++i)
    {
        /* if still have bytes to transmit from tx buffer */
        if (txLen > 0)
        {
            SPI4BUF = *p_txBuf++;
            --txLen;
        }
        /* else done writing bytes out from tx buffer */
        else
        {
            SPI4BUF = 0x00; /* clock out a "don't care" byte */
        }

        /* wait until tx/rx byte to completely clock out */
        WaitForDataByte();

        /* if still have bytes to read into rx buffer */
        if (rxLen > 0)
        {
            *p_rxBuf++ = SPI4BUF;
            --rxLen;
        }
            /* else done reading bytes into rx buffer */
        else
        {
            SPI4BUF; /* read and throw away byte */
        }
    } /* end for loop */
}

void SpiInit(void)
{
    /* disable the spi interrupt */
    // This will be the SPI4 RX register
    IEC5bits.SPI4RXIE = 0;
    IEC5bits.SPI4TXIE = 0;
    IEC5bits.SPI4EIE = 0;
    
    // * Set SPI2 as master.
    // * Set Primary Prescaler to 1:1, Secondary Prescaler to 2:1.  
    //     With Periph clock at 16MHz, SPI clock = 16MHz / 1 / 2 = 8MHz.
    // * Set SPI mode to 0:
    //     Output data changes from active (high) to idle (low) clock
    //     Idle state of clock is low, active state of clock is high
    // * Input data is sampled at middle of data output time              
    //SPI2CON = 0x013b;    // 8MHz [Prim. Prescal = 1:1, Second. Prescal=2:1
    //SPI2CON1 = 0x013f;    // 16MHz [Prim. Prescal = 1:1, Second. Prescal=1:1     
    //SPI2CON1 = 0x0130;    // 125KHz     occasional fails on scan test
    //SPI2CON1 = 0x0139;    // 450Khz
    
    // Set CKE, CKP and SMP to match above
    SPI4CON = 0;
    SPI4CONbits.CKE = 1;
    SPI4CONbits.CKP = 0;
    SPI4CONbits.SMP = 0;
    
    // Set SPI4 to master mode
    SPI4CONbits.MSTEN = 1;
    
    // Set SPI4BRG to get an 8Mhz SCK
    // PB2CLK = 84Mhz and we want a 8Mhz SCLK. So 
    // 8 = 84 / (2 * (BRG + 1) )
    // BRG = 5 for 7Mhz clock
    SPI4BRG = 5;
    
    // no frame sync or EBM
    SPI2CON2 = 0;
    
    // Clear the Overflow flag
    SPI4STATCLR = _SPI4STAT_SPIROV_MASK;
    
    // Set CS to idle high before SPI enable
    IO_RD2_SS2_SetHigh();
    
    // Enable SPI module
    SPI4CONbits.ON = 1;
    
//    SPI2CON2 = 0x0000;  // not using frame sync mode or enhanced buffer mode
//    SPI2STAT = 0x8000;  // Enable SPI module
}

#if defined(M2M_ENABLE_SPI_FLASH)
void m2m_wifi_console_write_data(uint16_t length, uint8_t *p_buf)
{
    uint16_t i;
    
    for (i = 0; i < length; ++i)
    {
        UART2_Write(p_buf[i]);
    }
}

uint8_t m2m_wifi_console_read_data(void)
{
    return UART2_Read();
}

bool m2m_wifi_console_is_read_data(void)
{
    return (U2STAbits.URXDA == 1);
}

#endif // M2M_ENABLE_SPI_FLASH
