TheJonBovi/AutomatedSmartBlinds/PIC32/EFG(new)/SmartBlinds.X/stepper_motor.c

////////////////////////////////////////////////////////////////////////////////
// File:	stepper_motor.c
// Author(s):	Chad Revel, Andrew Deraita, and Michael Roberts
// This is the stepper motor file that will control the rotating
// of the motor depending on what command is inputted.
////////////////////////////////////////////////////////////////////////////////

#include <xc.h>
#include <stdio.h>
#include <math.h>
#include "defines.h"
