TheJonBovi/AutomatedSmartBlinds/PIC32/EFG(new)/SmartBlinds.X/gas_functions.c

#include <xc.h>
#include <stdbool.h>
#include <math.h>
#include <sys/attribs.h>
#include "defines.h"

int gas_value = 0;

void gas_function(void)
{
    while (true)
    {
     /*
     if the gas/smoke is above the set alert number
     * then trigger the buzzer to turn on
     * else
     * do nothing
     */
        
    }
}
