TheJonBovi/AutomatedSmartBlinds/(commit log)

2019-10-31 Adding Datasheets
    Adding the Stepper Motor and Proximity Sensor datasheets to the documentation.
2019-10-31 created temperature unit project
    Added project for temp module for OLD board.
    No code yet, just example
2019-10-31 Create junior_project.xlsx
    Gantt Chart started week 5 for schedule will update every meeting
    [junior_project.xlsx]
2019-11-04 created main, config and ISR files
    Created the basis for the rest of the project, including a main routine to perform the RTS loop, as well as a config and ISR file to handle their respective duties.
    Also configured PBCLK3 and T2 and T3 according to CST337 lab as a proof-of-concept test. All configurations appear to be working so far in the simulator.
    Also added a specific datasheet for the ADC unit to the documentation folder.
2019-11-07 Update junior_project.xlsx
    Updated junior project plan
    [junior_project.xlsx]
2019-11-09 Added new pages for Current Status, Logs and Settings forms
2019-11-11 Began creating schematics in Eagle
    Began process of creating Eagle cad diagrams for each sub-module, starting with the stepper motors.
    [gas_sub_module.sch, motor_sub_module.sch]
2019-11-12 added more sub-module schematics
    added schematic for
    speaker
    temp sensor
    power supply
    gas sensor
    [buzzer_sub_module.sch, power_sub_module.sch, temp_sub_module.sch]
2019-11-13 initial ADC configuration written
    First three analog convertors (ADC0-2) configured for IR sensor inputs.
    Physical testing required.
2019-11-13 updated ADC init
    Added necessary ADCCON configuration that was forgotten. Still needs physical testing.
2019-11-14 Update junior_project.xlsx
    Updated after team meeting
    [junior_project.xlsx]
2019-11-15 ADC running (AN0 on ADC0)
    Confirmed running AN0 through ADC0. However, values range from 2048-4096, so some adjustment must be made.
    This does not currently scan the three analog inputs, just AN0
2019-11-15 ADDITIONAL NOTES ON PREVIOUS COMMIT
    so this ADC manually triggers with a software flag set and is polled until the value is returned. THis will need to be placed on an interrupt so the chip can do other things while the ADC is running
2019-11-15 adjusted ADC_config
    ADC clock speeds were too fast, giving inconsistent results. Once the clock was divided down to the appropriate value (between 1-23MHz) it now reads appropriately
    [system_config.c]
2019-11-17 Update junior_project.xlsx
    added Drew sections for the Gantt Chart, as well as initial filling in of timeframes
    [junior_project.xlsx]
2019-11-17 added LTSpice circuit simulations
    Created simulations for attenuating the 5V sensors to the 3.3V required for the microcontroller.
2019-11-18 added the rest of the schematics
    created schematics for the remaining sub-modules. Also fixed up some pin assignments for other schematics.
    Added voltage divider to 5V analog sensors for 3.3V operation with PIC
    [adafruid_breakout.brd, adafruid_breakout.sch, camera_sub_module.sch, gas_sub_module.sch, pic32_sub_module.sch, proximity_sub_module.sch, temp_sub_module.sch, wifi_sub_module.sch]
2019-11-18 updated schematics with pinouts
    Added pintout information for motors.
    [OC_motor_sub_module.sch, UD_motor_sub_module.sch, pic32_sub_module.sch]
2019-11-18 created state machines
    created state machine for Camera sub-module and started main() state machine.
2019-11-19 JP Planner
    Added my sections of the parts with a basic start for a timeframe of completion.
    [junior_project.xlsx]
2019-11-20 updated schematics with pinouts
    contined adding pinout information.
    Still need: Buzzer, Wifi
    [camera_sub_module.sch, led_sub_module.sch]
2019-11-20 added pictures for presentation
    added some schematics for presentation (more to follow).
    Also adjusted simulation for use in presentation
2019-11-21 schematic fully pinned out
    added psuedocode to main to test output LED's.
    finished pinouts after input from team's sub-module requests.
    [buzzer_sub_module.sch]
2019-11-21 Stepper Motor Diagram
    Adding a stepper motor state diagram picture along with the visio file.
2019-11-21 logic adjusted for demo
    got LED outputs working correctly with the ADC steps.
    also made defines for the values for easy adjustment. Adjusted logic was the only thing that I needed to do. Whoops C is hard.
    [main.c]
2019-11-22 created schematic images for presentation
    created individual png files for each sub-module schematic to be used in the presentation.
2019-11-22 Stepper Motor .c File
    Adding the start of the stepper motor .c file. Will be updating this a lot more once the presentation is over.
2019-11-22 demo values for Proximity programmed
    added ADC values for proximity sensor for use in the preliminary design review.
    Works great!
2019-11-27 set up TMR2 interrupt loop for ADC polling
    Configured TMR2 to operate in 32 bit mode to time out every 0.5 seconds to form the sensor polling loop.
    Not fully tested on board yet.
2019-11-28 Pickit 3 Datasheet
    Here is the PICkit 3 user's guide/data sheet for programming the board.
2019-11-28 added documentation for camera
2019-12-02 updated TMR2 operation for RTS loop
    Interrupt is triggereing but LED not toggling
2019-12-02 added defines.h files
    added header file to include all defines and related global variables for the project.
    Also moved ADC read routine to the TMR3 ISR for 0.5 second read timing.
    Good to work off for motors
2019-12-02 Update ISR.c
    added comment section to declare ISR priorites and shadowsets to avoid conflicts
    [ISR.c]
2019-12-02 ISR and dummy LED
    added a dummy LED that will flash every .5 seconds, and edited ISR TMR comments for what part they are assigned to.
2019-12-02 RK3 LED Flasher
    Added a new LED on RK3 that will flash every .5 seconds so we know the board is working.
2019-12-02 Stepper Motor Defines and Timer
    Set up the defines for each of the registers, and set up the timer function. Still need to set up the 8 cases for each signal step, and some extra parts.
2019-12-03 Motor Defines, State Cases, And Timer
    Set up the defines for the motor. The state cases were changed, and will be modified. Finally the timer function is fully set.
2019-12-03 adjusted a schematic and added a datasheet
    scheamtic updated with values for buzzer.
    also uploading a worksheet that chad and I did for the motors and buzzer
    [buzzer_sub_module.sch]
2019-12-03 fixing project gitignore issues hold on
    [ISR.c, defines.h, main.c, stepper_motor.c, system_config.c]
2019-12-03 re-added project to fix gitignore issues
    [ISR.c, defines.h, main.c, stepper_motor.c, system_config.c]
2019-12-04 Stepper Motor Ready For Testing
    Set up functions that should have the motor turn CW or CCW depending on what motor id is called. Also began the buzzer file. Will be filling out more soon.
    [buzzer.c, defines.h, stepper_motor.c]
2019-12-05 Buzzer Implemented
    The buzzer is implemented in the ISR and the T4 config is done in the system_config
    [ISR.c, buzzer.c, system_config.c]
2019-12-12 updated drew side of schedule
    [junior_project.xlsx]
2019-12-12 Update to JP schedule
    Have updated my section of the plan. Will update when starting to work on the parts.
    [junior_project.xlsx]
2019-12-12 Moved schedule
    moved schedule and renamed for clarity
    [Automated_Smart_Blinds_Gantt_Chart.xlsx]
2019-12-12 added turn ins for semester
    seperated our documentation for turn-in this semester for plan, schedule and control. Also turned in to Phong
    [ASB_Gantt_Chart.xlsx]
2019-12-17 started seperate project to config SPI for Camera
    Created SPI4 config file for use with the camera.
    Untested.
2020-01-02 Stepper Motor In Progress
    Continued working on getting the motor to rotate a full rotation, but only able to get the motor to turn on, and not rotate.
2020-01-07 Update Motor
    Changed the UDMOTOR settings for S7 from 13 to 12.
2020-01-07 Stepper motor basic function complete
    Both the UD and the OC stepper motors rotate both clockwise and counter clockwise. May need to alter the speed of the motor in the furture.
2020-01-07 added arduino stuff
    [Automated_Smart_Blinds_Gantt_Chart.xlsx]
2020-01-07 Buzzer test function complete
    Completed the buzzer function test to make sure that it produces sound. However, the dB seems to be a bit lower than what we were hoping. Might have to go with our alternative.
    [main.c, stepper_functions.c, system_config.c]
2020-01-07 Gant chart update
    Updated the gant chart for the steeper motor and buzzer initial tests.
    [Automated_Smart_Blinds_Gantt_Chart.xlsx]
2020-01-11 Switch Statement and Gantt Chart
    Started making the switch statement for the stepper motor, started making the counter for the motor revolution, and finally made adjustments to the Gantt Chart.
    [Automated_Smart_Blinds_Gantt_Chart.xlsx]
2020-01-14 Create WINC1500_SPI_Porting_Guide.pdf
    added document for porting SPI code to PIC32MZ
2020-01-17 Temp, Gas, and DIP
    Worked on the system_configs for the temperature, gas, and DIP. Also made a blueprint for the temperature and gas sensors in the ISR. Lastly, made #defines for them as well in the defines file.
2020-01-22 Temperature and gas functions initial
    Here are the initial changes for the temperature and gas function. Still need to flesh out the rest of the functions to work properly.
2020-01-29 Minor changes.
    Minor changes for the motor. Will be working on it more on the desktop.
2020-01-30 ASF project files
    ASF project files
    [atwinc1500_mr210pb_gain_setting.csv, samw25_gain_setting.csv]
2020-02-01 Motor full rotations complete
    Motors for both UD and OC will work both ways. There are also preset positions for each motor that can be used.
2020-02-01 upload new docs
    upload new docs
    [atwinc1500_mr210pb_gain_setting.csv, samw25_gain_setting.csv]
2020-02-01 Motor and Proxy Update
    Got the motors and the proxy to work together. Will fine tune it later.
2020-02-02 renamed projects to reflect current status of migration
    migration tested, wifi and motors working
2020-02-03 fixed up the speed of the motor
    full functional to continue development with all currently supported modules
    [defines.h, main.c]
2020-02-04 Monday work
    Got the motors redone with the proxy sensor. Also worked on timers 2, 3, 4, and 5.
2020-02-07 Gantt chart update
    updated the stepper, buzzer, temp, and sensor on the gantt chart.
    [Automated_Smart_Blinds_Gantt_Chart.xlsx]
2020-02-11 Temp and Gas Sensor
    Temp and Gas sensors starting to work. Still need to fine test them for their exact values.
2020-02-13 added SPI1.c for Camera commmunication function
    added initialize and read write single byte routines. Test read of the CHIP ID register (should output 0x40) is implemented but not tested as Camera is not attached to PIC yet.
2020-02-14 Web servers commands complete
    The first round of basic web server request commands and their various functions are complete and ready for testing. Also, the temperature and gas sensors are set to appropriate values and ready for further testing.
2020-02-21 I2C communication success
    Created I2C routines to communicate with camera sensor.
    Communication working, Configuration at 99% but the clear_fifo_flag function does not assert CS high again and complete its transmission.
    Need to figure out why
2020-02-21 minor adj to camera config
    still not tested
2020-02-23 set up Weather Client Example
    winc1500_weather_client is the primary state machine for the winc.
    It is currently set to connect to my (drew's) personal router. Settings for connections should be changed in the above file
2020-02-25 added rest of Camera SPI functions
    Still not 100% complete, but wanted a bookmark here.
    All that is really left is to deep test and save out the image file. Arduino code just sends the data via UART to the computer in its example so I"m going to have to save it somewhere.
2020-02-26 camera init working. I2C1 and SPI1 working as expected
2020-02-27 Created functions for capturing an image
    I think i am succesfully capturing images from the camera, but am unable to view them without sending to website.
    I know that the read_fifo_burst is successfully SPI'ing, as I can do other operations after like clear the fifo flag.
    I may need a bit of a delay in reading bytes out of the FIFO buffer, will determine once I can view the images
2020-02-27 final update for camera workings
2020-02-28 added buzzer initializer
    Testing for acutual blinds. Camera disabled as it is not hooked up yet
2020-03-03 code currently updates log with function 1
2020-03-04 Motor broken
    The motors are broken and is needing to be further debugged.
2020-03-04 Motor operating erratically
    The motors are not operating correctly.
    [defines.h]
2020-03-04 Motors fixed
    The up down motor has been fixed by increasing the MOTOR_PR_SETTING (which is slowing down the motor) to allow the steps to not get stopped via the torque.
    [defines.h, main.c]
2020-03-04 changed temperature reading value
    trying to geta farenhiet temp off sensor by conversion.
2020-03-05 Temperature Update
    Changed the temperature high and low settings for it to trigger the blinds to open or close.
2020-03-05 receive temperature and receive motor
    Set up the functions for both the temperature high setting and the 2 stepper motor settings that will allow them to be changed via the web server.
2020-03-05 wifi now opens and closes sockets for send and recieve successfully
2020-03-06 gas, temp and proxy 99% tested.
    Still need to test with actual motors and more regression testing.
2020-03-06 further organisation
    debouncing all proximity sensor sections
2020-03-06 watchdog timer startup
    Set up the blueprint for the watchdog in the main file, and set a couple pragma's in the mcc file.
2020-03-07 average temperature
    Set up the temperature to come out at an average and exclude the noise within the files of tmr2_3, mcc, and sensor_controls
2020-03-08 modified the proxy settings
    reduced the delay on the ADC reads from 0.5 seconds to 1.5ms for more consistent reading and for averaging purposes.
    Modifyed behavior of Proxy alarm settings.
2020-03-09 final working code for semester 2 presentation
    Code not done (image transfer broken) but this is good working code that is flashed to the chip for the secend semester presentation.
    [defines.h, main.c]
2020-04-29 added UART2 code back in
    Ordered and wired up a FTDI board to convert the UART2 output from code to a USB interface to read debugging output.
2020-04-30 New Speed Setting
    The UD motor's new setting of 620 being the maximum it can go without the motors not working. However, motorTargetUD is being set to 0 somehow, even though it's set to 1024. Will continue debugging it.
    [defines.h]
2020-05-01 updated schematics and uart routine
    pinout errors so had to correct.
    updated pintouts to reflect current board
    [pic32_sub_module.sch]
2020-05-06 lets do it
    try again
    [rubric_proposal.xls]
2020-05-06 Update uart2.c
    Fixed FTDI communication
2020-05-15 further image upload stuff and more error messages
    title
    [main.c, smartblinds_service.c]
2020-05-15 more work to get image transfer to work
    images confirmed to be taken successfully, but still not able to transfer via a GET request.
    To test camera, comment out call_control call in main, and comment the message_type to IMG_UPLOAD in defines.h
    [Automated_Smart_Blinds_Gantt_Chart.xlsx]
